kjaergaard-lab/fpga-servo/documentation/ClosedLoop.pdf

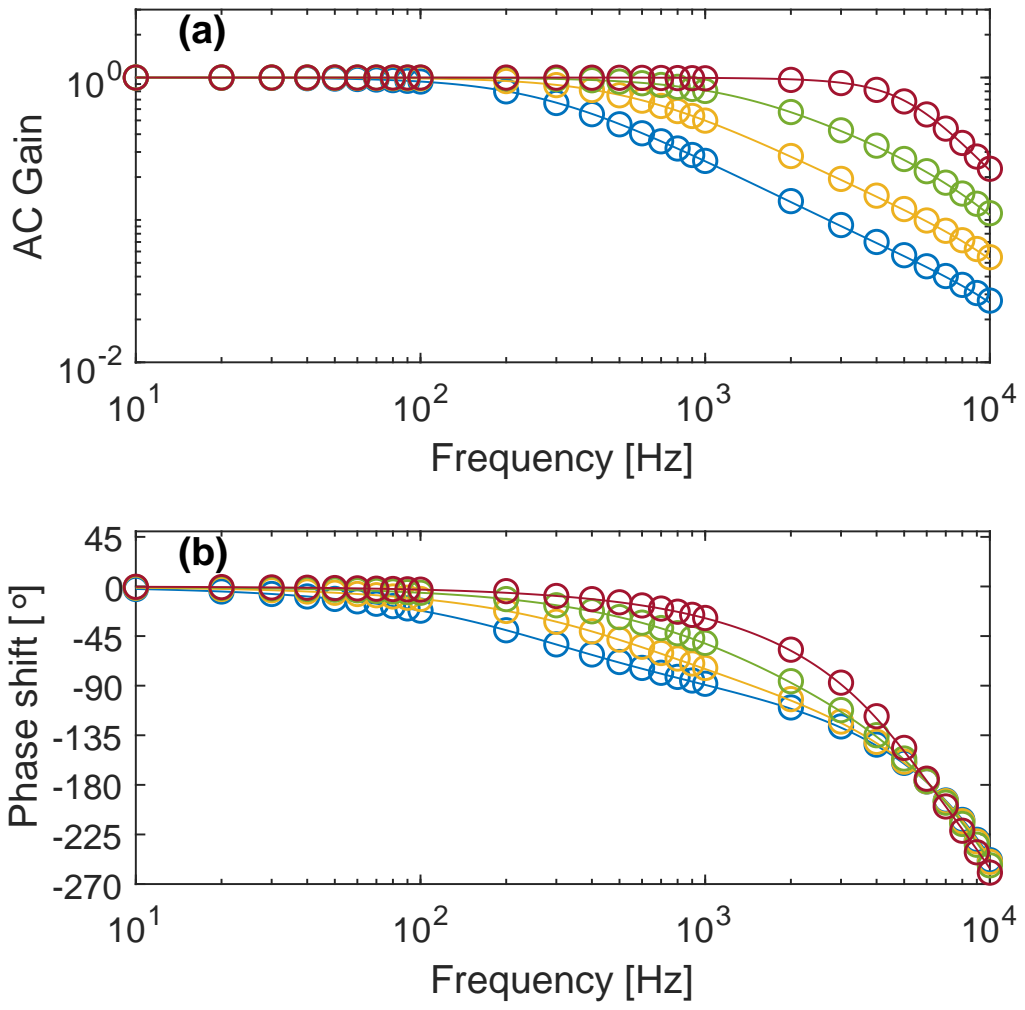
[picture p4: page 1]
Frequency [Hz]; AC Gain; Phase shift [°]
