kjaergaard-lab/fpga-servo/documentation/OpenLoop.pdf

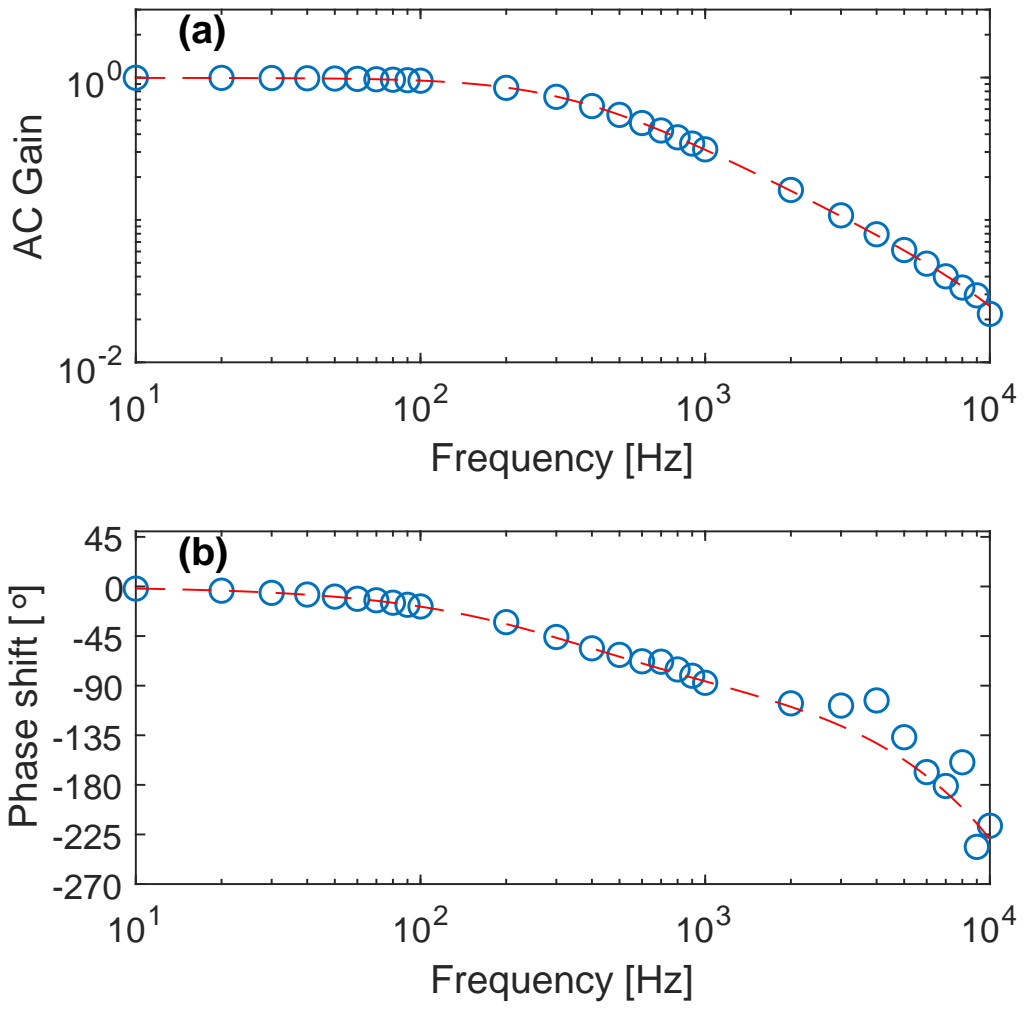
[picture p5: page 1]
Frequency [Hz]; AC Gain; Phase shift [°]
