kjaergaard-lab/fpga-servo/dual-servo/ipcore_dir/s6_lpddr_2channel/user_design/rtl/mcb_raw_wrapper.vhd

--*****************************************************************************
-- (c) Copyright 2009 Xilinx, Inc. All rights reserved.
--
-- This file contains confidential and proprietary information
-- of Xilinx, Inc. and is protected under U.S. and
-- international copyright and other intellectual property
-- laws.
--
-- DISCLAIMER
-- This disclaimer is not a license and does not grant any
-- rights to the materials distributed herewith. Except as
-- otherwise provided in a valid license issued to you by
-- Xilinx, and to the maximum extent permitted by applicable
-- law: (1) THESE MATERIALS ARE MADE AVAILABLE "AS IS" AND
-- WITH ALL FAULTS, AND XILINX HEREBY DISCLAIMS ALL WARRANTIES
-- AND CONDITIONS, EXPRESS, IMPLIED, OR STATUTORY, INCLUDING
-- BUT NOT LIMITED TO WARRANTIES OF MERCHANTABILITY, NON-
-- INFRINGEMENT, OR FITNESS FOR ANY PARTICULAR PURPOSE; and
-- (2) Xilinx shall not be liable (whether in contract or tort,
-- including negligence, or under any other theory of
-- liability) for any loss or damage of any kind or nature
-- related to, arising under or in connection with these
-- materials, including for any direct, or any indirect,
-- special, incidental, or consequential loss or damage
-- (including loss of data, profits, goodwill, or any type of
-- loss or damage suffered as a result of any action brought
-- by a third party) even if such damage or loss was
-- reasonably foreseeable or Xilinx had been advised of the
-- possibility of the same.
--
-- CRITICAL APPLICATIONS
-- Xilinx products are not designed or intended to be fail-
-- safe, or for use in any application requiring fail-safe
-- performance, such as life-support or safety devices or
-- systems, Class III medical devices, nuclear facilities,
-- applications related to the deployment of airbags, or any
-- other applications that could lead to death, personal
-- injury, or severe property or environmental damage
-- (individually and collectively, "Critical
-- Applications"). Customer assumes the sole risk and
-- liability of any use of Xilinx products in Critical
-- Applications, subject only to applicable laws and
-- regulations governing limitations on product liability.
--
-- THIS COPYRIGHT NOTICE AND DISCLAIMER MUST BE RETAINED AS
-- PART OF THIS FILE AT ALL TIMES.
--
--*****************************************************************************
--   ____  ____
--  /   /\/   /
-- /___/  \  /    Vendor: Xilinx
-- \   \   \/     Version: %version
--  \   \         Application: MIG
--  /   /         Filename: mcb_raw_wrapper.v
-- /___/   /\     Date Last Modified: $Date: 2011/06/02 07:17:04 $
-- \   \  /  \    Date Created: Thu June 24 2008
--  \___\/\___\
--
--Device: Spartan6
--Design Name: DDR/DDR2/DDR3/LPDDR 
--Purpose:
--Reference:
--   This module is the intialization control logic of the memory interface.
--   All commands are issued from here acoording to the burst, CAS Latency and
--   the user commands.
--   
-- Revised History:  
--    Rev 1.1 - added port_enable assignment for all configurations  and rearrange 
--              assignment siganls according to port number
--            - added timescale directive  -SN 7-28-08
--            - added C_ARB_NUM_TIME_SLOTS and removed the slot 12 through 
--              15 -SN 7-28-08
--            - changed C_MEM_DDR2_WRT_RECOVERY = (C_MEM_TWR /C_MEMCLK_PERIOD) -SN 7-28-08
--            - removed ghighb, gpwrdnb, gsr, gwe in port declaration. 
--              For now tb need to force the signals inside the MCB and Wrapper
--              until a glbl.v is ready.  Not sure how to do this in NCVerilog 
--              flow. -SN 7-28-08
--
--    Rev 1.2 -- removed p*_cmd_error signals -SN 8-05-08
--    Rev 1.3 -- Added gate logic for data port rd_en and wr_en in Config 3,4,5   - SN 8-8-08
--    Rev 1.4 -- update changes that required by MCB core.  - SN 9-11-09
--    Rev 1.5 -- update. CMD delays has been removed in Sept 26 database. -- SN 9-28-08
--               delay_cas_90,delay_ras_90,delay_cke_90,delay_odt_90,delay_rst_90 
--               delay_we_90 ,delay_address,delay_ba_90 =
--              --removed :assign #50 delay_dqnum = dqnum;
--              --removed :assign #50 delay_dqpum = dqpum;
--              --removed :assign #50 delay_dqnlm = dqnlm;
--              --removed :assign #50 delay_dqplm = dqplm;
--              --removed : delay_dqsIO_w_en_90_n
--              --removed : delay_dqsIO_w_en_90_p              
--              --removed : delay_dqsIO_w_en_0     
--              -- corrected spelling error: C_MEM_RTRAS
--    Rev 1.6 -- update IODRP2 and OSERDES connection and was updated by Chip.  1-12-09              
--                 -- rename the memc_wrapper.v to mcb_raw_wrapper.v
--    Rev 1.7  -- --  .READEN    is removed in IODRP2_MCB 1-28-09
--              -- connection has been updated                            
--    Rev 1.8   -- update memory parameter equations.    1-30_2009
--              -- added portion of Soft IP               
--              -- CAL_CLK_DIV is not used but MCB still has it
--    Rev  1.9  -- added Error checking for Invalid command to unidirectional port   
--    Rev  1.10 -- changed the backend connection so that Simulation will work while
--                 sw tools try to fix the model issues.                  2-3-2009      
--                 sysclk_2x_90 name is changed to sysclk_2x_180 . It created confusions.
--                 It is acutally 180 degree difference.
--    Rev  1.11 -- Added MCB_Soft_Calibration_top. 
--    Rev  1.12 -- fixed ui_clk connection to MCB when soft_calib_ip is on. 5-14-2009   
--    Rev  1.13 -- Added PULLUP/PULLDN for DQS/DQSN, UDQS/UDQSN lines.
--    Rev  1.14 -- Added minium condition for tRTP valud/                        
--    REv  1.15 -- Bring the SKIP_IN_TERM_CAL and SKIP_DYNAMIC_CAL from calib_ip to top.  6-16-2009
--    Rev  1.16 -- Fixed the WTR for DDR. 6-23-2009
--    Rev  1.17 -- Fixed width mismatch for px_cmd_ra,px_cmd_ca,px_cmd_ba 7-02-2009
--    Rev  1.18 -- Added lumpdelay parameters for 1.0 silicon support to bypass Calibration 7-10-2010
--    Rev  1.19 -- Added soft fix to support refresh command. 7-15-2009.
--    Rev  1.20 -- Turned on the CALIB_SOFT_IP and C_MC_CALIBRATION_MODE is used to enable/disable
--                 Dynamic DQS calibration in Soft Calibration module.
--    Rev  1.21 -- Added extra generate mcbx_dram_odt pin condition. It will not be generated if
--                 RTT value is set to "disabled"
--              -- Corrected the UIUDQSDEC connection between soft_calib and MCB.
--              -- PLL_LOCK pin to MCB tie high. Soft Calib module asserts MCB_RST when pll_lock is deasserted. 1-19-2010                
--    Rev  1.22 -- Added DDR2 Initialization fix to meet 400 ns wait as outlined in step d) of JEDEC DDR2 spec .
--    Rev  1.23 -- Fixed  CR 558661.  In Config "B64B64" mode, mig_p5_wr_data  <= p1_wr_data(63 downto 32).
--    Rev  1.24 -- Added DDR2 Initialization fix when C_CALIB_SOFT_IP set to "FALSE"
--    Rev  1.25 -- Fixed reset problem when MCB exits from SUSPEND SELFREFRESH mode. 10-20-2010	 
--    Rev  1.26 -- Synchronize sys_rst before connecting to mcb_soft_calibration module to fix
--                 CDC static timing issue.	 2-14-2011


--*************************************************************************************************************************
library ieee;
   use ieee.std_logic_1164.all;
   use ieee.std_logic_unsigned.all;
library unisim;
use unisim.vcomponents.all;

entity mcb_raw_wrapper is
generic(
      C_MEMCLK_PERIOD                  : integer := 2500;
      C_PORT_ENABLE                    : std_logic_vector(5 downto 0) := (others => '1');

      C_MEM_ADDR_ORDER                 : string := "BANK_ROW_COLUMN";
      
      C_ARB_NUM_TIME_SLOTS             : integer := 12;
      C_ARB_TIME_SLOT_0                : bit_vector(17 downto 0):= "000" & "001" & "010" & "011" & "100" & "101";
      C_ARB_TIME_SLOT_1                : bit_vector(17 downto 0):= "001" & "010" & "011" & "100" & "101" & "000";
      C_ARB_TIME_SLOT_2                : bit_vector(17 downto 0):= "010" & "011" & "100" & "101" & "000" & "011"; 
      C_ARB_TIME_SLOT_3                : bit_vector(17 downto 0):= "011" & "100" & "101" & "000" & "001" & "010";
      C_ARB_TIME_SLOT_4                : bit_vector(17 downto 0):= "100" & "101" & "000" & "001" & "010" & "011";
      C_ARB_TIME_SLOT_5                : bit_vector(17 downto 0):= "101" & "000" & "001" & "010" & "011" & "100";
      C_ARB_TIME_SLOT_6                : bit_vector(17 downto 0):= "000" & "001" & "010" & "011" & "100" & "101";
      C_ARB_TIME_SLOT_7                : bit_vector(17 downto 0):= "001" & "010" & "011" & "100" & "101" & "000";
      C_ARB_TIME_SLOT_8                : bit_vector(17 downto 0):= "010" & "011" & "100" & "101" & "000" & "011"; 
      C_ARB_TIME_SLOT_9                : bit_vector(17 downto 0):= "011" & "100" & "101" & "000" & "001" & "010";
      C_ARB_TIME_SLOT_10               : bit_vector(17 downto 0):= "100" & "101" & "000" & "001" & "010" & "011";
      C_ARB_TIME_SLOT_11               : bit_vector(17 downto 0):= "101" & "000" & "001" & "010" & "011" & "100";
      C_PORT_CONFIG                    : string :=  "B32_B32_W32_W32_W32_W32";  

      
      C_MEM_TRAS                       : integer := 45000;
      C_MEM_TRCD                       : integer := 12500;
      C_MEM_TREFI                      : integer := 7800;
      C_MEM_TRFC                       : integer := 127500;
      C_MEM_TRP                        : integer := 12500;
      C_MEM_TWR                        : integer := 15000;
      C_MEM_TRTP                       : integer := 7500;
      C_MEM_TWTR                       : integer := 7500;
      
      C_NUM_DQ_PINS                    : integer := 8;
      C_MEM_TYPE                       : string := "DDR3";
      C_MEM_DENSITY                    : string := "512M";
      C_MEM_BURST_LEN                  : integer := 8;
      
      C_MEM_CAS_LATENCY                : integer := 4;
      C_MEM_ADDR_WIDTH                 : integer := 13;
      C_MEM_BANKADDR_WIDTH             : integer := 3;
      C_MEM_NUM_COL_BITS               : integer := 11;
      
      C_MEM_DDR3_CAS_LATENCY           : integer := 7;
      C_MEM_MOBILE_PA_SR               : string := "FULL";
      C_MEM_DDR1_2_ODS                 : string := "FULL";
      C_MEM_DDR3_ODS                   : string := "DIV6";
      C_MEM_DDR2_RTT                   : string := "50OHMS";
      C_MEM_DDR3_RTT                   : string := "DIV2";
      C_MEM_MDDR_ODS                   : string := "FULL";
      
      C_MEM_DDR2_DIFF_DQS_EN           : string := "YES";
      C_MEM_DDR2_3_PA_SR               : string := "OFF";
      C_MEM_DDR3_CAS_WR_LATENCY        : integer := 5;
      
      C_MEM_DDR3_AUTO_SR               : string := "ENABLED";
      C_MEM_DDR2_3_HIGH_TEMP_SR        : string := "NORMAL";
      C_MEM_DDR3_DYN_WRT_ODT           : string := "OFF";
      C_MEM_TZQINIT_MAXCNT             : std_logic_vector(9 downto 0) := "1000000000"; -- DDR3 Minimum delay between resets 
      
      C_MC_CALIB_BYPASS                : string := "NO";
      C_MC_CALIBRATION_RA              : bit_vector(15 downto 0) := X"0000";
      C_MC_CALIBRATION_BA              : bit_vector(2 downto 0) := "000";

      C_CALIB_SOFT_IP                  : string := "TRUE";
      C_SKIP_IN_TERM_CAL               : integer := 0;        --provides option to skip the input termination calibration
      C_SKIP_DYNAMIC_CAL               : integer := 0;        --provides option to skip the dynamic delay calibration
      C_SKIP_DYN_IN_TERM               : integer := 1;        -- provides option to skip the input termination calibration
      C_SIMULATION                     : string  := "FALSE";  -- Tells us whether the design is being simulated or implemented


--- ADDED for 1.0 silicon support to bypass Calibration //////
-- 07-10-09 chipl
--////////////////////////////////////////////////////////////
     LDQSP_TAP_DELAY_VAL                : integer := 0;
     UDQSP_TAP_DELAY_VAL                : integer := 0;
     LDQSN_TAP_DELAY_VAL                : integer := 0;
     UDQSN_TAP_DELAY_VAL                : integer := 0;
     DQ0_TAP_DELAY_VAL                  : integer := 0;  
     DQ1_TAP_DELAY_VAL                  : integer := 0;  
     DQ2_TAP_DELAY_VAL                  : integer := 0;  
     DQ3_TAP_DELAY_VAL                  : integer := 0;  
     DQ4_TAP_DELAY_VAL                  : integer := 0;  
     DQ5_TAP_DELAY_VAL                  : integer := 0;  
     DQ6_TAP_DELAY_VAL                  : integer := 0;  
     DQ7_TAP_DELAY_VAL                  : integer := 0;  
     DQ8_TAP_DELAY_VAL                  : integer := 0;  
     DQ9_TAP_DELAY_VAL                  : integer := 0;  
     DQ10_TAP_DELAY_VAL                  : integer := 0;  
     DQ11_TAP_DELAY_VAL                  : integer := 0;  
     DQ12_TAP_DELAY_VAL                  : integer := 0;  
     DQ13_TAP_DELAY_VAL                  : integer := 0;  
     DQ14_TAP_DELAY_VAL                  : integer := 0;  
     DQ15_TAP_DELAY_VAL                  : integer := 0;  

      C_MC_CALIBRATION_CA              : bit_vector(11 downto 0) := X"000";
      C_MC_CALIBRATION_CLK_DIV         : integer := 1;
      C_MC_CALIBRATION_MODE            : string := "CALIBRATION";
      C_MC_CALIBRATION_DELAY           : string := "HALF";
      
      C_P0_MASK_SIZE                   : integer := 4;
      C_P0_DATA_PORT_SIZE              : integer := 32;
      C_P1_MASK_SIZE                   : integer := 4;
      C_P1_DATA_PORT_SIZE              : integer := 32
      );
   PORT (

      sysclk_2x                        : in std_logic;
      sysclk_2x_180                    : in std_logic;
      pll_ce_0                         : in std_logic;
      pll_ce_90                        : in std_logic;
      pll_lock                         : in std_logic;
      sys_rst                          : in std_logic;
      
      p0_arb_en                        : in std_logic;
      p0_cmd_clk                       : in std_logic;
      p0_cmd_en                        : in std_logic;
      p0_cmd_instr                     : in std_logic_vector(2 downto 0);
      p0_cmd_bl                        : in std_logic_vector(5 downto 0);
      p0_cmd_byte_addr                 : in std_logic_vector(29 downto 0);
      p0_cmd_empty                     : out std_logic;
      p0_cmd_full                      : out std_logic;

      p0_wr_clk                        : in std_logic;
      p0_wr_en                         : in std_logic;
      p0_wr_mask                       : in std_logic_vector(C_P0_MASK_SIZE - 1 downto 0);
      p0_wr_data                       : in std_logic_vector(C_P0_DATA_PORT_SIZE - 1 downto 0);
      p0_wr_full                       : out std_logic;
      p0_wr_empty                      : out std_logic;
      p0_wr_count                      : out std_logic_vector(6 downto 0);
      p0_wr_underrun                   : out std_logic;
      p0_wr_error                      : out std_logic;

      p0_rd_clk                        : in std_logic;
      p0_rd_en                         : in std_logic;
      p0_rd_data                       : out std_logic_vector(C_P0_DATA_PORT_SIZE - 1 downto 0);
      p0_rd_full                       : out std_logic;
      p0_rd_empty                      : out std_logic;
      p0_rd_count                      : out std_logic_vector(6 downto 0);
      p0_rd_overflow                   : out std_logic;
      p0_rd_error                      : out std_logic;

      p1_arb_en                        : in std_logic;
      p1_cmd_clk                       : in std_logic;
      p1_cmd_en                        : in std_logic;
      p1_cmd_instr                     : in std_logic_vector(2 downto 0);
      p1_cmd_bl                        : in std_logic_vector(5 downto 0);
      p1_cmd_byte_addr                 : in std_logic_vector(29 downto 0);
      p1_cmd_empty                     : out std_logic;
      p1_cmd_full                      : out std_logic;
      p1_wr_clk                        : in std_logic;
      p1_wr_en                         : in std_logic;
      p1_wr_mask                       : in std_logic_vector(C_P1_MASK_SIZE - 1 downto 0);
      p1_wr_data                       : in std_logic_vector(C_P1_DATA_PORT_SIZE - 1 downto 0);
      p1_wr_full                       : out std_logic;
      p1_wr_empty                      : out std_logic;
      p1_wr_count                      : out std_logic_vector(6 downto 0);
      p1_wr_underrun                   : out std_logic;
      p1_wr_error                      : out std_logic;
      p1_rd_clk                        : in std_logic;
      p1_rd_en                         : in std_logic;
      p1_rd_data                       : out std_logic_vector(C_P1_DATA_PORT_SIZE - 1 downto 0);
      p1_rd_full                       : out std_logic;
      p1_rd_empty                      : out std_logic;
      p1_rd_count                      : out std_logic_vector(6 downto 0);
      p1_rd_overflow                   : out std_logic;
      p1_rd_error                      : out std_logic;

      p2_arb_en                        : in std_logic;
      p2_cmd_clk                       : in std_logic;
      p2_cmd_en                        : in std_logic;
      p2_cmd_instr                     : in std_logic_vector(2 downto 0);
      p2_cmd_bl                        : in std_logic_vector(5 downto 0);
      p2_cmd_byte_addr                 : in std_logic_vector(29 downto 0);
      p2_cmd_empty                     : out std_logic;
      p2_cmd_full                      : out std_logic;
      p2_wr_clk                        : in std_logic;
      p2_wr_en                         : in std_logic;
      p2_wr_mask                       : in std_logic_vector(3 downto 0);
      p2_wr_data                       : in std_logic_vector(31 downto 0);
      p2_wr_full                       : out std_logic;
      p2_wr_empty                      : out std_logic;
      p2_wr_count                      : out std_logic_vector(6 downto 0);
      p2_wr_underrun                   : out std_logic;
      p2_wr_error                      : out std_logic;
      p2_rd_clk                        : in std_logic;
      p2_rd_en                         : in std_logic;
      p2_rd_data                       : out std_logic_vector(31 downto 0);
      p2_rd_full                       : out std_logic;
      p2_rd_empty                      : out std_logic;
      p2_rd_count                      : out std_logic_vector(6 downto 0);
      p2_rd_overflow                   : out std_logic;
      p2_rd_error                      : out std_logic;

      p3_arb_en                        : in std_logic;
      p3_cmd_clk                       : in std_logic;
      p3_cmd_en                        : in std_logic;
      p3_cmd_instr                     : in std_logic_vector(2 downto 0);
      p3_cmd_bl                        : in std_logic_vector(5 downto 0);
      p3_cmd_byte_addr                 : in std_logic_vector(29 downto 0);
      p3_cmd_empty                     : out std_logic;
      p3_cmd_full                      : out std_logic;
      p3_wr_clk                        : in std_logic;
      p3_wr_en                         : in std_logic;
      p3_wr_mask                       : in std_logic_vector(3 downto 0);
      p3_wr_data                       : in std_logic_vector(31 downto 0);
      p3_wr_full                       : out std_logic;
      p3_wr_empty                      : out std_logic;
      p3_wr_count                      : out std_logic_vector(6 downto 0);
      p3_wr_underrun                   : out std_logic;
      p3_wr_error                      : out std_logic;
      p3_rd_clk                        : in std_logic;
      p3_rd_en                         : in std_logic;
      p3_rd_data                       : out std_logic_vector(31 downto 0);
      p3_rd_full                       : out std_logic;
      p3_rd_empty                      : out std_logic;
      p3_rd_count                      : out std_logic_vector(6 downto 0);
      p3_rd_overflow                   : out std_logic;
      p3_rd_error                      : out std_logic;

      p4_arb_en                        : in std_logic;
      p4_cmd_clk                       : in std_logic;
      p4_cmd_en                        : in std_logic;
      p4_cmd_instr                     : in std_logic_vector(2 downto 0);
      p4_cmd_bl                        : in std_logic_vector(5 downto 0);
      p4_cmd_byte_addr                 : in std_logic_vector(29 downto 0);
      p4_cmd_empty                     : out std_logic;
      p4_cmd_full                      : out std_logic;
      p4_wr_clk                        : in std_logic;
      p4_wr_en                         : in std_logic;
      p4_wr_mask                       : in std_logic_vector(3 downto 0);
      p4_wr_data                       : in std_logic_vector(31 downto 0);
      p4_wr_full                       : out std_logic;
      p4_wr_empty                      : out std_logic;
      p4_wr_count                      : out std_logic_vector(6 downto 0);
      p4_wr_underrun                   : out std_logic;
      p4_wr_error                      : out std_logic;
      p4_rd_clk                        : in std_logic;
      p4_rd_en                         : in std_logic;
      p4_rd_data                       : out std_logic_vector(31 downto 0);
      p4_rd_full                       : out std_logic;
      p4_rd_empty                      : out std_logic;
      p4_rd_count                      : out std_logic_vector(6 downto 0);
      p4_rd_overflow                   : out std_logic;
      p4_rd_error                      : out std_logic;

      p5_arb_en                        : in std_logic;
      p5_cmd_clk                       : in std_logic;
      p5_cmd_en                        : in std_logic;
      p5_cmd_instr                     : in std_logic_vector(2 downto 0);
      p5_cmd_bl                        : in std_logic_vector(5 downto 0);
      p5_cmd_byte_addr                 : in std_logic_vector(29 downto 0);
      p5_cmd_empty                     : out std_logic;
      p5_cmd_full                      : out std_logic;
      p5_wr_clk                        : in std_logic;
      p5_wr_en                         : in std_logic;
      p5_wr_mask                       : in std_logic_vector(3 downto 0);
      p5_wr_data                       : in std_logic_vector(31 downto 0);
      p5_wr_full                       : out std_logic;
      p5_wr_empty                      : out std_logic;
      p5_wr_count                      : out std_logic_vector(6 downto 0);
      p5_wr_underrun                   : out std_logic;
      p5_wr_error                      : out std_logic;
      p5_rd_clk                        : in std_logic;
      p5_rd_en                         : in std_logic;
      p5_rd_data                       : out std_logic_vector(31 downto 0);
      p5_rd_full                       : out std_logic;
      p5_rd_empty                      : out std_logic;
      p5_rd_count                      : out std_logic_vector(6 downto 0);
      p5_rd_overflow                   : out std_logic;
      p5_rd_error                      : out std_logic;

      mcbx_dram_addr                   : out std_logic_vector(C_MEM_ADDR_WIDTH - 1 downto 0);
      mcbx_dram_ba                     : out std_logic_vector(C_MEM_BANKADDR_WIDTH - 1 downto 0);
      mcbx_dram_ras_n                  : out std_logic;
      mcbx_dram_cas_n                  : out std_logic;
      mcbx_dram_we_n                   : out std_logic;
      mcbx_dram_cke                    : out std_logic;
      mcbx_dram_clk                    : out std_logic;
      mcbx_dram_clk_n                  : out std_logic;
      mcbx_dram_dq                     : INOUT std_logic_vector(C_NUM_DQ_PINS-1 downto 0);
      mcbx_dram_dqs                    : INOUT std_logic;
      mcbx_dram_dqs_n                  : INOUT std_logic;
      mcbx_dram_udqs                   : INOUT std_logic;
      mcbx_dram_udqs_n                 : INOUT std_logic;
      mcbx_dram_udm                    : out std_logic;
      mcbx_dram_ldm                    : out std_logic;
      mcbx_dram_odt                    : out std_logic;
      mcbx_dram_ddr3_rst               : out std_logic;

      calib_recal                      : in std_logic;
      rzq                              : INOUT std_logic;
      zio                              : INOUT std_logic;
      ui_read                          : in std_logic;
      ui_add                           : in std_logic;
      ui_cs                            : in std_logic;
      ui_clk                           : in std_logic;
      ui_sdi                           : in std_logic;
      ui_addr                          : in std_logic_vector(4 downto 0);
      ui_broadcast                     : in std_logic;
      ui_drp_update                    : in std_logic;
      ui_done_cal                      : in std_logic;
      ui_cmd                           : in std_logic;
      ui_cmd_in                        : in std_logic;
      ui_cmd_en                        : in std_logic;
      ui_dqcount                       : in std_logic_vector(3 downto 0);
      ui_dq_lower_dec                  : in std_logic;
      ui_dq_lower_inc                  : in std_logic;
      ui_dq_upper_dec                  : in std_logic;
      ui_dq_upper_inc                  : in std_logic;
      ui_udqs_inc                      : in std_logic;
      ui_udqs_dec                      : in std_logic;
      ui_ldqs_inc                      : in std_logic;
      ui_ldqs_dec                      : in std_logic;
      uo_data                          : out std_logic_vector(7 downto 0);
      uo_data_valid                    : out std_logic;
      uo_done_cal                      : out std_logic;
      uo_cmd_ready_in                  : out std_logic;
      uo_refrsh_flag                   : out std_logic;
      uo_cal_start                     : out std_logic;
      uo_sdo                           : out std_logic;
      status                           : out std_logic_vector(31 downto 0);
      selfrefresh_enter                : in std_logic;
      selfrefresh_mode                 : out std_logic
   );
end mcb_raw_wrapper;

 architecture aarch of mcb_raw_wrapper is
   
component mcb_soft_calibration_top is
   generic (
      C_MEM_TZQINIT_MAXCNT  : std_logic_vector(9 downto 0) := "1000000000"; -- DDR3 Minimum delay between resets 
      C_MC_CALIBRATION_MODE : string :=  "CALIBRATION";  -- if set to CALIBRATION will reset DQS IDELAY to DQS_NUMERATOR/DQS_DENOMINATOR local_param values,
                                                         --  and does dynamic recal,
                                                         -- if set to NOCALIBRATION then defaults to hard cal blocks setting of C_MC_CALBRATION_DELAY *and* 
                                                         --  no dynamic recal will be done 
      SKIP_IN_TERM_CAL      : integer := 0;             -- provides option to skip the input termination calibration
      SKIP_DYNAMIC_CAL      : integer := 0;             -- provides option to skip the dynamic delay calibration
      SKIP_DYN_IN_TERM      : integer := 0;             -- provides option to skip the dynamic delay calibration
      C_SIMULATION          : string  := "FALSE";       -- Tells us whether the design is being simulated or implemented
      C_MEM_TYPE            : string  := "DDR3"         -- provides the memory device used for the design

   );
   port (
      UI_CLK                : in std_logic;             -- Input - global clock to be used for input_term_tuner and IODRP clock
      RST                   : in std_logic;             -- Input - reset for input_term_tuner - synchronous for input_term_tuner state machine, asynch for 
                                                        --  IODRP (sub)controller
      IOCLK                 : in std_logic;             -- Input - IOCLK input to the IODRP's
      DONE_SOFTANDHARD_CAL  : out std_logic;            -- active high flag signals soft calibration of input delays is complete and MCB_UODONECAL is high
                                                        --  (MCB hard calib complete)
      PLL_LOCK              : in std_logic;             -- Lock signal from PLL
      SELFREFRESH_REQ       : in std_logic;             
      SELFREFRESH_MCB_MODE  : in std_logic;             
      SELFREFRESH_MCB_REQ   : out std_logic;            
      SELFREFRESH_MODE      : out std_logic;            
      MCB_UIADD             : out std_logic;            -- to MCB's UIADD port
      MCB_UISDI             : out std_logic;            -- to MCB's UISDI port
      MCB_UOSDO             : in std_logic;
      MCB_UODONECAL         : in std_logic;
      MCB_UOREFRSHFLAG      : in std_logic;
      MCB_UICS              : out std_logic;
      MCB_UIDRPUPDATE       : out std_logic;
      MCB_UIBROADCAST       : out std_logic;
      MCB_UIADDR            : out std_logic_vector(4 downto 0);
      MCB_UICMDEN           : out std_logic;
      MCB_UIDONECAL         : out std_logic;
      MCB_UIDQLOWERDEC      : out std_logic;
      MCB_UIDQLOWERINC      : out std_logic;
      MCB_UIDQUPPERDEC      : out std_logic;
      MCB_UIDQUPPERINC      : out std_logic;
      MCB_UILDQSDEC         : out std_logic;
      MCB_UILDQSINC         : out std_logic;
      MCB_UIREAD            : out std_logic;
      MCB_UIUDQSDEC         : out std_logic;
      MCB_UIUDQSINC         : out std_logic;
      MCB_RECAL             : out std_logic;
      MCB_SYSRST            : out std_logic;
      MCB_UICMD             : out std_logic;
      MCB_UICMDIN           : out std_logic;
      MCB_UIDQCOUNT         : out std_logic_vector(3 downto 0);
      MCB_UODATA            : in std_logic_vector(7 downto 0);
      MCB_UODATAVALID       : in std_logic;
      MCB_UOCMDREADY        : in std_logic;
      MCB_UO_CAL_START      : in std_logic;
      RZQ_PIN               : inout std_logic;
      ZIO_PIN               : inout std_logic;
      CKE_Train             : out std_logic
   );   
end component;

constant      C_OSERDES2_DATA_RATE_OQ          : STRING := "SDR";
constant      C_OSERDES2_DATA_RATE_OT          : STRING := "SDR";
constant      C_OSERDES2_SERDES_MODE_MASTER    : STRING := "MASTER";
constant      C_OSERDES2_SERDES_MODE_SLAVE     : STRING := "SLAVE";
constant      C_OSERDES2_OUTPUT_MODE_SE        : STRING := "SINGLE_ENDED";
constant      C_OSERDES2_OUTPUT_MODE_DIFF      : STRING := "DIFFERENTIAL";
      
constant      C_BUFPLL_0_LOCK_SRC              : STRING := "LOCK_TO_0";
      
constant      C_DQ_IODRP2_DATA_RATE            : STRING := "SDR";
constant      C_DQ_IODRP2_SERDES_MODE_MASTER   : STRING := "MASTER";
constant      C_DQ_IODRP2_SERDES_MODE_SLAVE    : STRING := "SLAVE";
      
constant      C_DQS_IODRP2_DATA_RATE           : STRING := "SDR";
constant      C_DQS_IODRP2_SERDES_MODE_MASTER  : STRING := "MASTER";
constant      C_DQS_IODRP2_SERDES_MODE_SLAVE   : STRING := "SLAVE";

-- MIG always set the below ADD_LATENCY to zero
constant      C_MEM_DDR3_ADD_LATENCY           : STRING := "OFF";
constant      C_MEM_DDR2_ADD_LATENCY           : INTEGER := 0;
constant      C_MEM_MOBILE_TC_SR               : INTEGER := 0;

-- convert the memory timing to memory clock units. I
constant      MEM_RAS_VAL   : INTEGER := ((C_MEM_TRAS + C_MEMCLK_PERIOD - 1) / C_MEMCLK_PERIOD);
constant      MEM_RCD_VAL   : INTEGER := ((C_MEM_TRCD + C_MEMCLK_PERIOD - 1) / C_MEMCLK_PERIOD);
constant      MEM_REFI_VAL  : INTEGER := ((C_MEM_TREFI + C_MEMCLK_PERIOD - 1) / C_MEMCLK_PERIOD) - 25;
constant      MEM_RFC_VAL   : INTEGER := ((C_MEM_TRFC + C_MEMCLK_PERIOD - 1) / C_MEMCLK_PERIOD);
constant      MEM_RP_VAL    : INTEGER := ((C_MEM_TRP + C_MEMCLK_PERIOD - 1) / C_MEMCLK_PERIOD);
constant      MEM_WR_VAL    : INTEGER := ((C_MEM_TWR + C_MEMCLK_PERIOD - 1) / C_MEMCLK_PERIOD);

 function cdiv return integer is
  begin
    if ( (C_MEM_TRTP mod C_MEMCLK_PERIOD)>0) then
      return (C_MEM_TRTP/C_MEMCLK_PERIOD)+1;
    else      
    return (C_MEM_TRTP/C_MEMCLK_PERIOD);
    end if;
  end function cdiv;

constant      MEM_RTP_VAL1                      : INTEGER := cdiv;


function MEM_RTP_CYC1 return integer is
  begin
    if (MEM_RTP_VAL1 < 4 and C_MEM_TYPE = "DDR3") then
      return 4;
    else if(MEM_RTP_VAL1 < 2) then
      return 2;
    else
      return MEM_RTP_VAL1;
    end if;
    end if;
  end function MEM_RTP_CYC1;

constant      MEM_RTP_VAL                      : INTEGER := MEM_RTP_CYC1;

function MEM_WTR_CYC return integer is
  begin
    if (C_MEM_TYPE = "DDR") then
      return 2;
    elsif (C_MEM_TYPE = "DDR3") then
      return 4;
    elsif (C_MEM_TYPE = "MDDR" OR C_MEM_TYPE = "LPDDR") then
      return C_MEM_TWTR;
    elsif (C_MEM_TYPE = "DDR2"  AND (((C_MEM_TWTR  + C_MEMCLK_PERIOD -1) /C_MEMCLK_PERIOD) > 2)) then
      return ((C_MEM_TWTR  + C_MEMCLK_PERIOD -1) /C_MEMCLK_PERIOD);
    elsif (C_MEM_TYPE = "DDR2")then
      return 2;
    else
      return 3;
    end if;
  end function MEM_WTR_CYC;

constant      MEM_WTR_VAL                      : INTEGER := MEM_WTR_CYC;

function DDR2_WRT_RECOVERY_CYC return integer is
  begin
    if (not(C_MEM_TYPE = "DDR2")) then
      return 5;
    else
      return ((C_MEM_TWR + C_MEMCLK_PERIOD - 1) / C_MEMCLK_PERIOD);
    end if;
  end function DDR2_WRT_RECOVERY_CYC;


constant        C_MEM_DDR2_WRT_RECOVERY          : INTEGER := DDR2_WRT_RECOVERY_CYC;

function DDR3_WRT_RECOVERY_CYC return integer is
  begin
    if (not(C_MEM_TYPE = "DDR3")) then
      return 5;
    else
      return ((C_MEM_TWR + C_MEMCLK_PERIOD - 1) / C_MEMCLK_PERIOD);
    end if;
  end function DDR3_WRT_RECOVERY_CYC;

constant      C_MEM_DDR3_WRT_RECOVERY          : INTEGER := DDR3_WRT_RECOVERY_CYC;

--CR 596422
constant allzero : std_logic_vector(127 downto 0) := (others => '0');
--signal allzero : std_logic_vector(127 downto 0) := (others => '0');

----------------------------------------------------------------------------
-- signal Declarations
----------------------------------------------------------------------------
signal addr_in0 : std_logic_vector(31 downto 0);
signal dqs_out_p : std_logic;              
signal dqs_out_n : std_logic;              
signal dqs_sys_p : std_logic;             --from dqs_gen to IOclk network
signal dqs_sys_n : std_logic;             --from dqs_gen to IOclk network
signal udqs_sys_p: std_logic;
signal udqs_sys_n: std_logic;
signal dqs_p : std_logic;                  -- open net now ?
signal dqs_n : std_logic;                  -- open net now ?

-- IOI and IOB enable/tristate interface
signal dqIO_w_en_0      : std_logic;          --enable DQ pads
signal dqsIO_w_en_90_p  : std_logic;          --enable p side of DQS
signal dqsIO_w_en_90_n  : std_logic;          --enable n side of DQS

--memory chip control interface
signal address_90 : std_logic_vector(14 downto 0);
signal ba_90  : std_logic_vector(2 downto 0);   
signal ras_90 : std_logic;
signal cas_90 : std_logic;
signal we_90  : std_logic;
signal cke_90 : std_logic;
signal odt_90 : std_logic;
signal rst_90 : std_logic;

-- calibration IDELAY control  signals
signal ioi_drp_clk       : std_logic;   --DRP interface - synchronous clock output
signal ioi_drp_addr      : std_logic_vector(4 downto 0);   --DRP interface - IOI selection
signal ioi_drp_sdo       : std_logic;   --DRP interface - serial output for commmands
signal ioi_drp_sdi       : std_logic;   --DRP interface - serial input for commands
signal ioi_drp_cs        : std_logic;   --DRP interface - chip select doubles as DONE signal
signal ioi_drp_add       : std_logic;   --DRP interface - serial address signal
signal ioi_drp_broadcast : std_logic; 
signal ioi_drp_train     : std_logic;

-- Calibration datacapture siganls
signal dqdonecount : std_logic_vector(3 downto 0); --select signal for the datacapture 16 to 1 mux
signal dq_in_p : std_logic;         --positive signal sent to calibration logic
signal dq_in_n : std_logic;         --negative signal sent to calibration logic
signal cal_done: std_logic;   

--DQS calibration interface
signal udqs_n : std_logic;
signal udqs_p : std_logic;
signal udqs_dqocal_p : std_logic;
signal udqs_dqocal_n : std_logic;

-- MUI enable interface
signal df_en_n90 : std_logic;

--INTERNAL signal FOR DRP chain
-- IOI <-> MUI
signal ioi_int_tmp : std_logic;

signal dqo_n : std_logic_vector(15 downto 0);  
signal dqo_p : std_logic_vector(15 downto 0);  
signal dqnlm : std_logic;      
signal dqplm : std_logic;      
signal dqnum : std_logic;      
signal dqpum : std_logic;      

-- IOI <-> IOB   routes
signal  ioi_addr  : std_logic_vector(C_MEM_ADDR_WIDTH-1 downto 0);
signal  ioi_ba : std_logic_vector(C_MEM_BANKADDR_WIDTH-1 downto 0);    
signal  ioi_cas : std_logic;  
signal  ioi_ck  : std_logic;  
signal  ioi_ckn : std_logic;   
signal  ioi_cke : std_logic;  
signal  ioi_dq : std_logic_vector(C_NUM_DQ_PINS-1 downto 0); 
signal  ioi_dqs  : std_logic; 
signal  ioi_dqsn : std_logic;
signal  ioi_udqs : std_logic;
signal  ioi_udqsn : std_logic;   
signal  ioi_odt  : std_logic; 
signal  ioi_ras  : std_logic; 
signal  ioi_rst  : std_logic; 
signal  ioi_we   : std_logic;
signal  ioi_udm  : std_logic;
signal  ioi_ldm  : std_logic;

signal  in_dq     : std_logic_vector(15 downto 0);
signal  in_pre_dq : std_logic_vector(C_NUM_DQ_PINS-1 downto 0);
signal  in_dqs       : std_logic;
signal  in_pre_dqsp  : std_logic;
signal  in_pre_dqsn  : std_logic;
signal  in_pre_udqsp : std_logic;
signal  in_pre_udqsn : std_logic;
signal  in_udqs      : std_logic;

-- Memory tri-state control signals
signal  t_addr  : std_logic_vector(C_MEM_ADDR_WIDTH-1 downto 0);
signal  t_ba    : std_logic_vector(C_MEM_BANKADDR_WIDTH-1 downto 0);    
signal  t_cas   : std_logic;
signal  t_ck    : std_logic;
signal  t_ckn   : std_logic;
signal  t_cke   : std_logic;
signal  t_dq    : std_logic_vector(C_NUM_DQ_PINS-1 downto 0);
signal  t_dqs   : std_logic;   
signal  t_dqsn  : std_logic;
signal  t_udqs  : std_logic;
signal  t_udqsn : std_logic;
signal  t_odt   : std_logic;   
signal  t_ras   : std_logic;   
signal  t_rst   : std_logic;   
signal  t_we    : std_logic;   

signal t_udm             : std_logic;
signal t_ldm             : std_logic;

signal idelay_dqs_ioi_s  : std_logic;
signal idelay_dqs_ioi_m  : std_logic;
signal idelay_udqs_ioi_s : std_logic;
signal idelay_udqs_ioi_m : std_logic;

signal dqs_pin           : std_logic;
signal udqs_pin          : std_logic;

-- USER Interface signals
-- translated memory addresses
signal p0_cmd_ra : std_logic_vector(14 downto 0);
signal p0_cmd_ba : std_logic_vector(2 downto 0);
signal p0_cmd_ca : std_logic_vector(11 downto 0);
signal p1_cmd_ra : std_logic_vector(14 downto 0);
signal p1_cmd_ba : std_logic_vector(2 downto 0);
signal p1_cmd_ca : std_logic_vector(11 downto 0);
signal p2_cmd_ra : std_logic_vector(14 downto 0);
signal p2_cmd_ba : std_logic_vector(2 downto 0);
signal p2_cmd_ca : std_logic_vector(11 downto 0);
signal p3_cmd_ra : std_logic_vector(14 downto 0);
signal p3_cmd_ba : std_logic_vector(2 downto 0);
signal p3_cmd_ca : std_logic_vector(11 downto 0);
signal p4_cmd_ra : std_logic_vector(14 downto 0);
signal p4_cmd_ba : std_logic_vector(2 downto 0);
signal p4_cmd_ca : std_logic_vector(11 downto 0);
signal p5_cmd_ra : std_logic_vector(14 downto 0);
signal p5_cmd_ba : std_logic_vector(2 downto 0);
signal p5_cmd_ca : std_logic_vector(11 downto 0);

   -- user command wires mapped from logical ports to physical ports
signal mig_p0_arb_en            : std_logic;
signal mig_p0_cmd_clk           : std_logic;
signal mig_p0_cmd_en            : std_logic;
signal mig_p0_cmd_ra            : std_logic_vector(14 downto 0);
signal mig_p0_cmd_ba            : std_logic_vector(2 downto 0);
signal mig_p0_cmd_ca            : std_logic_vector(11 downto 0);

signal mig_p0_cmd_instr         : std_logic_vector(2 downto 0);
signal mig_p0_cmd_bl            : std_logic_vector(5 downto 0);
signal mig_p0_cmd_empty         : std_logic;
signal mig_p0_cmd_full          : std_logic;

signal mig_p1_arb_en            : std_logic;
signal mig_p1_cmd_clk           : std_logic;
signal mig_p1_cmd_en            : std_logic;
signal mig_p1_cmd_ra            : std_logic_vector(14 downto 0);
signal mig_p1_cmd_ba            : std_logic_vector(2 downto 0);
signal mig_p1_cmd_ca            : std_logic_vector(11 downto 0);

signal mig_p1_cmd_instr         : std_logic_vector(2 downto 0);
signal mig_p1_cmd_bl            : std_logic_vector(5 downto 0);
signal mig_p1_cmd_empty         : std_logic;
signal mig_p1_cmd_full          : std_logic;

signal mig_p2_arb_en            : std_logic;
signal mig_p2_cmd_clk           : std_logic;
signal mig_p2_cmd_en            : std_logic;
signal mig_p2_cmd_ra            : std_logic_vector(14 downto 0);
signal mig_p2_cmd_ba            : std_logic_vector(2 downto 0);
signal mig_p2_cmd_ca            : std_logic_vector(11 downto 0);

signal mig_p2_cmd_instr         : std_logic_vector(2 downto 0);
signal mig_p2_cmd_bl            : std_logic_vector(5 downto 0);
signal mig_p2_cmd_empty         : std_logic;
signal mig_p2_cmd_full          : std_logic;

signal mig_p3_arb_en            : std_logic;
signal mig_p3_cmd_clk           : std_logic;
signal mig_p3_cmd_en            : std_logic;
signal mig_p3_cmd_ra            : std_logic_vector(14 downto 0);
signal mig_p3_cmd_ba            : std_logic_vector(2 downto 0);
signal mig_p3_cmd_ca            : std_logic_vector(11 downto 0);

signal mig_p3_cmd_instr         : std_logic_vector(2 downto 0);
signal mig_p3_cmd_bl            : std_logic_vector(5 downto 0);
signal mig_p3_cmd_empty         : std_logic;
signal mig_p3_cmd_full          : std_logic;

signal mig_p4_arb_en            : std_logic;
signal mig_p4_cmd_clk           : std_logic;
signal mig_p4_cmd_en            : std_logic;
signal mig_p4_cmd_ra            : std_logic_vector(14 downto 0);
signal mig_p4_cmd_ba            : std_logic_vector(2 downto 0);
signal mig_p4_cmd_ca            : std_logic_vector(11 downto 0);

signal mig_p4_cmd_instr         : std_logic_vector(2 downto 0);
signal mig_p4_cmd_bl            : std_logic_vector(5 downto 0);
signal mig_p4_cmd_empty         : std_logic;
signal mig_p4_cmd_full          : std_logic;

signal mig_p5_arb_en            : std_logic;
signal mig_p5_cmd_clk           : std_logic;
signal mig_p5_cmd_en            : std_logic;
signal mig_p5_cmd_ra            : std_logic_vector(14 downto 0);
signal mig_p5_cmd_ba            : std_logic_vector(2 downto 0);
signal mig_p5_cmd_ca            : std_logic_vector(11 downto 0);

signal mig_p5_cmd_instr         : std_logic_vector(2 downto 0);
signal mig_p5_cmd_bl            : std_logic_vector(5 downto 0);
signal mig_p5_cmd_empty         : std_logic;
signal mig_p5_cmd_full          : std_logic;

signal mig_p0_wr_clk            : std_logic;
signal mig_p0_rd_clk            : std_logic;
signal mig_p1_wr_clk            : std_logic;
signal mig_p1_rd_clk            : std_logic;
signal mig_p2_clk               : std_logic;
signal mig_p3_clk               : std_logic;
signal mig_p4_clk               : std_logic;
signal mig_p5_clk               : std_logic;

signal mig_p0_wr_en             : std_logic;
signal mig_p0_rd_en             : std_logic;
signal mig_p1_wr_en             : std_logic;
signal mig_p1_rd_en             : std_logic;
signal mig_p2_en                : std_logic;
signal mig_p3_en                : std_logic;
signal mig_p4_en                : std_logic;
signal mig_p5_en                : std_logic;

signal mig_p0_wr_data           : std_logic_vector(31 downto 0);
signal mig_p1_wr_data           : std_logic_vector(31 downto 0);
signal mig_p2_wr_data           : std_logic_vector(31 downto 0);
signal mig_p3_wr_data           : std_logic_vector(31 downto 0);
signal mig_p4_wr_data           : std_logic_vector(31 downto 0);
signal mig_p5_wr_data           : std_logic_vector(31 downto 0);

signal mig_p0_wr_mask           : std_logic_vector(C_P0_MASK_SIZE - 1 downto 0);
signal mig_p1_wr_mask           : std_logic_vector(C_P1_MASK_SIZE - 1 downto 0);
signal mig_p2_wr_mask           : std_logic_vector(3 downto 0);
signal mig_p3_wr_mask           : std_logic_vector(3 downto 0);
signal mig_p4_wr_mask           : std_logic_vector(3 downto 0);
signal mig_p5_wr_mask           : std_logic_vector(3 downto 0);

signal mig_p0_rd_data           : std_logic_vector(31 downto 0);
signal mig_p1_rd_data           : std_logic_vector(31 downto 0);
signal mig_p2_rd_data           : std_logic_vector(31 downto 0);
signal mig_p3_rd_data           : std_logic_vector(31 downto 0);
signal mig_p4_rd_data           : std_logic_vector(31 downto 0);
signal mig_p5_rd_data           : std_logic_vector(31 downto 0);

signal mig_p0_rd_overflow       : std_logic;
signal mig_p1_rd_overflow       : std_logic;
signal mig_p2_overflow          : std_logic;
signal mig_p3_overflow          : std_logic;

signal mig_p4_overflow          : std_logic;
signal mig_p5_overflow          : std_logic;

signal mig_p0_wr_underrun       : std_logic;
signal mig_p1_wr_underrun       : std_logic;
signal mig_p2_underrun          : std_logic;
signal mig_p3_underrun          : std_logic;
signal mig_p4_underrun          : std_logic;
signal mig_p5_underrun          : std_logic;

signal mig_p0_rd_error          : std_logic;
signal mig_p0_wr_error          : std_logic;
signal mig_p1_rd_error          : std_logic;
signal mig_p1_wr_error          : std_logic;
signal mig_p2_error             : std_logic;
signal mig_p3_error             : std_logic;
signal mig_p4_error             : std_logic;
signal mig_p5_error             : std_logic;

signal mig_p0_wr_count          : std_logic_vector(6 downto 0);
signal mig_p1_wr_count          : std_logic_vector(6 downto 0);
signal mig_p0_rd_count          : std_logic_vector(6 downto 0);
signal mig_p1_rd_count          : std_logic_vector(6 downto 0);

signal mig_p2_count             : std_logic_vector(6 downto 0);
signal mig_p3_count             : std_logic_vector(6 downto 0);
signal mig_p4_count             : std_logic_vector(6 downto 0);
signal mig_p5_count             : std_logic_vector(6 downto 0);

signal mig_p0_wr_full           : std_logic;
signal mig_p1_wr_full           : std_logic;

signal mig_p0_rd_empty          : std_logic;
signal mig_p1_rd_empty          : std_logic;
signal mig_p0_wr_empty          : std_logic;
signal mig_p1_wr_empty          : std_logic;
signal mig_p0_rd_full           : std_logic;
signal mig_p1_rd_full           : std_logic;
signal mig_p2_full              : std_logic;
signal mig_p3_full              : std_logic;
signal mig_p4_full              : std_logic;
signal mig_p5_full              : std_logic;
signal mig_p2_empty             : std_logic;
signal mig_p3_empty             : std_logic;
signal mig_p4_empty             : std_logic;
signal mig_p5_empty             : std_logic;

-- SELFREESH control signal for suspend feature
signal selfrefresh_mcb_enter    : std_logic;
signal selfrefresh_mcb_mode     : std_logic;
signal selfrefresh_mode_sig     : std_logic;

signal MCB_SYSRST : std_logic;
signal ioclk0  : std_logic;
signal ioclk90 : std_logic;
signal hard_done_cal       : std_logic;
signal uo_data_int         : std_logic_vector(7 downto 0);
signal uo_data_valid_int   : std_logic;
signal uo_cmd_ready_in_int : std_logic;
signal syn_uiclk_pll_lock  : std_logic;
signal int_sys_rst         : std_logic;

--testing
signal ioi_drp_update : std_logic;
signal aux_sdi_sdo : std_logic_vector(7 downto 0);


   signal mcb_recal                : std_logic;
   signal mcb_ui_read              : std_logic;
   signal mcb_ui_add               : std_logic;
   signal mcb_ui_cs                : std_logic;
   signal mcb_ui_clk               : std_logic;
   signal mcb_ui_sdi               : std_logic;
   signal mcb_ui_addr              : STD_LOGIC_vector(4 downto 0);
   signal mcb_ui_broadcast         : std_logic;
   signal mcb_ui_drp_update        : std_logic;
   signal mcb_ui_done_cal          : std_logic;
   signal mcb_ui_cmd               : std_logic;
   signal mcb_ui_cmd_in            : std_logic;
   signal mcb_ui_cmd_en            : std_logic;
   signal mcb_ui_dqcount           : std_logic_vector(3 downto 0);
   signal mcb_ui_dq_lower_dec      : std_logic;
   signal mcb_ui_dq_lower_inc      : std_logic;
   signal mcb_ui_dq_upper_dec      : std_logic;
   signal mcb_ui_dq_upper_inc      : std_logic;
   signal mcb_ui_udqs_inc          : std_logic;
   signal mcb_ui_udqs_dec          : std_logic;
   signal mcb_ui_ldqs_inc          : std_logic;
   signal mcb_ui_ldqs_dec          : std_logic;
   signal DONE_SOFTANDHARD_CAL     : std_logic;

   signal ck_shiftout0_1           : std_logic;
   signal ck_shiftout0_2           : std_logic;
   signal ck_shiftout1_3           : std_logic;
   signal ck_shiftout1_4           : std_logic;

   signal udm_oq                   : std_logic;
   signal udm_t                    : std_logic;
   signal ldm_oq                   : std_logic;
   signal ldm_t                    : std_logic;
   signal dqsp_oq                  : std_logic;
   signal dqsp_tq                  : std_logic;
   signal dqs_shiftout0_1          : std_logic;
   signal dqs_shiftout0_2          : std_logic;
   signal dqs_shiftout1_3          : std_logic;
   signal dqs_shiftout1_4          : std_logic;
   signal dqsn_oq                  : std_logic;
   signal dqsn_tq                  : std_logic;
   signal udqsp_oq                 : std_logic;
   signal udqsp_tq                 : std_logic;
   signal udqs_shiftout0_1         : std_logic;
   signal udqs_shiftout0_2         : std_logic;
   signal udqs_shiftout1_3         : std_logic;
   signal udqs_shiftout1_4         : std_logic;
   signal udqsn_oq                 : std_logic;
   signal udqsn_tq                 : std_logic;
   signal aux_sdi_out_dqsp         : std_logic;
   signal aux_sdi_out_udqsp        : std_logic;
   signal aux_sdi_out_udqsn        : std_logic;
   signal aux_sdi_out_0            : std_logic;
   signal aux_sdi_out_1            : std_logic;
   signal aux_sdi_out_2            : std_logic;
   signal aux_sdi_out_3            : std_logic;
   signal aux_sdi_out_5            : std_logic;
   signal aux_sdi_out_6            : std_logic;
   signal aux_sdi_out_7            : std_logic;
   signal aux_sdi_out_9            : std_logic;
   signal aux_sdi_out_10           : std_logic;
   signal aux_sdi_out_11           : std_logic;
   signal aux_sdi_out_12           : std_logic;
   signal aux_sdi_out_13           : std_logic;
   signal aux_sdi_out_14           : std_logic;
   signal aux_sdi_out_15           : std_logic;
   signal aux_sdi_out_8            : std_logic;
   signal aux_sdi_out_dqsn         : std_logic;
   signal aux_sdi_out_4            : std_logic;
   signal aux_sdi_out_udm          : std_logic;
   signal aux_sdi_out_ldm          : std_logic;
   signal uo_cal_start_int         : std_logic;
 
   signal cke_train                : std_logic;
   signal dq_oq                    : std_logic_vector(C_NUM_DQ_PINS-1 downto 0);
   signal dq_tq                    : std_logic_vector(C_NUM_DQ_PINS-1 downto 0);

   signal p0_wr_full_i             : std_logic;
   signal p0_rd_empty_i            : std_logic;
   signal p1_wr_full_i             : std_logic;
   signal p1_rd_empty_i            : std_logic;
   signal pllclk1                  : std_logic_vector(1 downto 0);
   signal pllce1                   : std_logic_vector(1 downto 0);
   signal uo_refrsh_flag_xhdl23    : std_logic;
   signal uo_sdo_xhdl24            : STD_LOGIC;
   signal Max_Value_Cal_Error      : std_logic;
   signal uo_done_cal_sig          : std_logic;
   signal wait_200us_counter       : std_logic_vector(15 downto 0);
   signal cke_train_reg            : std_logic;        
   signal wait_200us_done_r1       : std_logic;
   signal wait_200us_done_r2       : std_logic;
   signal syn1_sys_rst             : std_logic;
   signal syn2_sys_rst             : std_logic;
   signal selfrefresh_enter_r1     : std_logic;
   signal selfrefresh_enter_r2     : std_logic;
   signal selfrefresh_enter_r3     : std_logic;
   signal gated_pll_lock           : std_logic;
   signal soft_cal_selfrefresh_req : std_logic;
   signal normal_operation_window  : std_logic;

   attribute max_fanout            : string;
   attribute syn_maxfan            : integer;
   attribute max_fanout of int_sys_rst : signal is "1";
   attribute syn_maxfan of int_sys_rst : signal is 1;

begin
   uo_cmd_ready_in   <= uo_cmd_ready_in_int;
   uo_data_valid     <= uo_data_valid_int;
   uo_data           <= uo_data_int;
   uo_refrsh_flag    <= uo_refrsh_flag_xhdl23;
   uo_sdo            <= uo_sdo_xhdl24;

   p0_wr_full        <= p0_wr_full_i;
   p0_rd_empty       <= p0_rd_empty_i;
   p1_wr_full        <= p1_wr_full_i;
   p1_rd_empty       <= p1_rd_empty_i;
   ioclk0            <= sysclk_2x;
   ioclk90           <= sysclk_2x_180;
   pllclk1           <= (ioclk90 & ioclk0);
   pllce1            <= (pll_ce_90 & pll_ce_0);

   -- Assign the output signals with corresponding intermediate signals
   uo_done_cal       <= uo_done_cal_sig;

   -- Added 2/22 - Add flop to pll_lock status signal to improve timing
   process (ui_clk)
   begin
      if (ui_clk'event and ui_clk = '1') then      
        if ((selfrefresh_enter = '0') and (gated_pll_lock = '0')) then
         syn_uiclk_pll_lock <= pll_lock;
        end if;
      end if;
   end process;               

   -- logic to determine if Memory  is SELFREFRESH mode operation or NORMAL  mode.
   process (ui_clk)
   begin
      if (ui_clk'event and ui_clk = '1') then      
        if (sys_rst = '1') then  
           normal_operation_window <= '1';
        elsif (selfrefresh_enter_r2 = '1' or selfrefresh_mode_sig = '1') then
           normal_operation_window <= '0';
        elsif ((selfrefresh_enter_r2 = '0') and  (selfrefresh_mode_sig = '0')) then
           normal_operation_window <= '1';
        else
           normal_operation_window <= normal_operation_window;
        end if;
      end if;
   end process;   
   
   
   process(normal_operation_window,pll_lock,syn_uiclk_pll_lock)
   begin
     if (normal_operation_window = '1') then
      gated_pll_lock <= pll_lock;
     else
      gated_pll_lock <= syn_uiclk_pll_lock;
     end if;
   end process;

-- int_sys_rst will be asserted if pll lose lock during normal operation.
-- It uses the syn_uiclk_pll_lock version when it is entering suspend window , hence
-- reset will not be generated. 

   int_sys_rst <=  sys_rst or not(gated_pll_lock);

-- synchronize the selfrefresh_enter 
   process (ui_clk)
   begin
      if (ui_clk'event and ui_clk = '1') then      
        if (sys_rst = '1') then
          selfrefresh_enter_r1 <= '0';
          selfrefresh_enter_r2 <= '0';
          selfrefresh_enter_r3 <= '0';
        else
          selfrefresh_enter_r1 <= selfrefresh_enter;
          selfrefresh_enter_r2 <= selfrefresh_enter_r1;
          selfrefresh_enter_r3 <= selfrefresh_enter_r2;
        end if;
      end if;
    end process;



--  The soft_cal_selfrefresh siganl is conditioned before connect to mcb_soft_calibration module.
--  It will not deassert selfrefresh_mcb_enter to MCB until input pll_lock reestablished in system.
--  This is to ensure the IOI stables before issued a selfrefresh exit command to dram.
   process (ui_clk)
   begin
      if (ui_clk'event and ui_clk = '1') then      
        if (sys_rst = '1') then
          soft_cal_selfrefresh_req <= '0';
        elsif (selfrefresh_enter_r3 = '1') then
          soft_cal_selfrefresh_req <= '1';
        elsif (selfrefresh_enter_r3 = '0' and pll_lock = '1') then 
          soft_cal_selfrefresh_req <= '0';
        else
          soft_cal_selfrefresh_req <= soft_cal_selfrefresh_req;
        end if;
      end if;
    end process;
  

--Address Remapping
-- Byte Address remapping
-- 
-- Bank Address[x:0] & Row Address[x:0]  & Column Address[x:0]
-- column address remap for port 0

x16_addr        : if(C_NUM_DQ_PINS = 16) generate  --  port bus remapping sections for CONFIG 2   15,3,12
x16_addr_rbc    : if (C_MEM_ADDR_ORDER = "ROW_BANK_COLUMN") generate -- C_MEM_ADDR_ORDER = 0 : Bank Row  Column

-- port 0 address remapping
                
 x16_p0_a15     : if (C_MEM_ADDR_WIDTH = 15) generate
                   p0_cmd_ra <= p0_cmd_byte_addr(C_MEM_ADDR_WIDTH + C_MEM_BANKADDR_WIDTH + C_MEM_NUM_COL_BITS downto C_MEM_BANKADDR_WIDTH + C_MEM_NUM_COL_BITS + 1);                         
                end generate;

 x16_p0_a15_n : if (not(C_MEM_ADDR_WIDTH = 15)) generate
                   p0_cmd_ra <= (allzero(14 downto C_MEM_ADDR_WIDTH) &  p0_cmd_byte_addr(C_MEM_ADDR_WIDTH + C_MEM_BANKADDR_WIDTH + C_MEM_NUM_COL_BITS downto C_MEM_BANKADDR_WIDTH +  C_MEM_NUM_COL_BITS + 1)); 
                   end generate;
                      

 x16_p0_ba3 :       if (C_MEM_BANKADDR_WIDTH  = 3 ) generate --Bank
                        p0_cmd_ba <= p0_cmd_byte_addr( C_MEM_BANKADDR_WIDTH +  C_MEM_NUM_COL_BITS   downto   C_MEM_NUM_COL_BITS + 1);
                end generate;

 x16_p0_ba3_n :   if (not(C_MEM_BANKADDR_WIDTH  = 3 )) generate --Bank
                        p0_cmd_ba <=  (allzero(2 downto C_MEM_BANKADDR_WIDTH) & p0_cmd_byte_addr(C_MEM_BANKADDR_WIDTH +   C_MEM_NUM_COL_BITS   downto  + C_MEM_NUM_COL_BITS + 1));
                end generate;

                
 x16_p0_ca12 :     if (C_MEM_NUM_COL_BITS = 12)  generate --Column
                        p0_cmd_ca <= p0_cmd_byte_addr(C_MEM_NUM_COL_BITS downto 1);
                end generate;

 x16_p0_ca12_n :     if (not(C_MEM_NUM_COL_BITS = 12))  generate --Column
                        p0_cmd_ca <=  (allzero(12 downto C_MEM_NUM_COL_BITS + 1) & p0_cmd_byte_addr(C_MEM_NUM_COL_BITS downto 1));
                end generate;

-- port 1 address remapping
  
 x16_p1_a15     : if (C_MEM_ADDR_WIDTH = 15) generate  --Row  
                        p1_cmd_ra <=  p1_cmd_byte_addr(C_MEM_ADDR_WIDTH + C_MEM_BANKADDR_WIDTH + C_MEM_NUM_COL_BITS   downto C_MEM_BANKADDR_WIDTH + C_MEM_NUM_COL_BITS + 1);                         
                end generate;

 x16_p1_a15_n : if (not(C_MEM_ADDR_WIDTH = 15)) generate --Row  
                        p1_cmd_ra <= (allzero(14 downto C_MEM_ADDR_WIDTH) &  p1_cmd_byte_addr(C_MEM_ADDR_WIDTH + C_MEM_BANKADDR_WIDTH + C_MEM_NUM_COL_BITS   downto C_MEM_BANKADDR_WIDTH +  C_MEM_NUM_COL_BITS + 1));                            
                   end generate;
                      

 x16_p1_ba3 :       if (C_MEM_BANKADDR_WIDTH  = 3 ) generate --Bank
                        p1_cmd_ba <= p1_cmd_byte_addr(C_MEM_BANKADDR_WIDTH +  C_MEM_NUM_COL_BITS   downto   C_MEM_NUM_COL_BITS + 1);
                end generate;

 x16_p1_ba3_n :   if (not(C_MEM_BANKADDR_WIDTH  = 3 )) generate --Bank
                        p1_cmd_ba <= (allzero(2 downto C_MEM_BANKADDR_WIDTH) & p1_cmd_byte_addr(C_MEM_BANKADDR_WIDTH +   C_MEM_NUM_COL_BITS   downto  + C_MEM_NUM_COL_BITS + 1));

                end generate;

                
 x16_p1_ca12 :     if (C_MEM_NUM_COL_BITS = 12)  generate --Column
                        p1_cmd_ca <= p1_cmd_byte_addr(C_MEM_NUM_COL_BITS downto 1);

                end generate;

 x16_p1_ca12_n :     if (not(C_MEM_NUM_COL_BITS = 12))  generate --Column
                        p1_cmd_ca <= (allzero(12 downto C_MEM_NUM_COL_BITS + 1) & p1_cmd_byte_addr(C_MEM_NUM_COL_BITS downto 1));

                end generate;

 -- port 2 address remapping
 x16_p2_a15     : if (C_MEM_ADDR_WIDTH = 15) generate --Row  
                         p2_cmd_ra <= p2_cmd_byte_addr(C_MEM_ADDR_WIDTH + C_MEM_BANKADDR_WIDTH + C_MEM_NUM_COL_BITS   downto C_MEM_BANKADDR_WIDTH + C_MEM_NUM_COL_BITS + 1);                         
                end generate;

 x16_p2_a15_n : if (not(C_MEM_ADDR_WIDTH = 15)) generate --Row  
                         p2_cmd_ra <= (allzero(14 downto C_MEM_ADDR_WIDTH) &  p2_cmd_byte_addr (C_MEM_ADDR_WIDTH + C_MEM_BANKADDR_WIDTH + C_MEM_NUM_COL_BITS   downto C_MEM_BANKADDR_WIDTH +  C_MEM_NUM_COL_BITS + 1));                         
                   end generate;
                      

 x16_p2_ba3 :       if (C_MEM_BANKADDR_WIDTH  = 3 ) generate --Bank
                         p2_cmd_ba <= p2_cmd_byte_addr(C_MEM_BANKADDR_WIDTH +  C_MEM_NUM_COL_BITS   downto   C_MEM_NUM_COL_BITS + 1);
                end generate;

 x16_p2_ba3_n :   if (not(C_MEM_BANKADDR_WIDTH  = 3 )) generate --Bank
                         p2_cmd_ba <= (allzero(2 downto C_MEM_BANKADDR_WIDTH) & p2_cmd_byte_addr(C_MEM_BANKADDR_WIDTH +   C_MEM_NUM_COL_BITS   downto   C_MEM_NUM_COL_BITS + 1));
                end generate;

                
 x16_p2_ca12 :     if (C_MEM_NUM_COL_BITS = 12)  generate --Column
                         p2_cmd_ca <= p2_cmd_byte_addr(C_MEM_NUM_COL_BITS downto 1);

                end generate;

 x16_p2_ca12_n :     if (not(C_MEM_NUM_COL_BITS = 12))  generate --Column
                         p2_cmd_ca <= (allzero(12 downto C_MEM_NUM_COL_BITS + 1) & p2_cmd_byte_addr(C_MEM_NUM_COL_BITS downto 1));

                end generate;
                

-- port 3 address remapping
 x16_p3_a15     : if (C_MEM_ADDR_WIDTH = 15) generate --Row  
                         p3_cmd_ra <= p3_cmd_byte_addr(C_MEM_ADDR_WIDTH + C_MEM_BANKADDR_WIDTH + C_MEM_NUM_COL_BITS   downto C_MEM_BANKADDR_WIDTH + C_MEM_NUM_COL_BITS + 1);                         

                end generate;

 x16_p3_a15_n : if (not(C_MEM_ADDR_WIDTH = 15)) generate --Row  
                        p3_cmd_ra <= (allzero(14 downto C_MEM_ADDR_WIDTH) &  p3_cmd_byte_addr(C_MEM_ADDR_WIDTH + C_MEM_BANKADDR_WIDTH + C_MEM_NUM_COL_BITS   downto C_MEM_BANKADDR_WIDTH +  C_MEM_NUM_COL_BITS + 1));                         
                   end generate;
                      

 x16_p3_ba3 :       if (C_MEM_BANKADDR_WIDTH  = 3 ) generate --Bank
                         p3_cmd_ba <= p3_cmd_byte_addr(C_MEM_BANKADDR_WIDTH +  C_MEM_NUM_COL_BITS   downto   C_MEM_NUM_COL_BITS + 1);

                end generate;

 x16_p3_ba3_n :   if (not(C_MEM_BANKADDR_WIDTH  = 3 )) generate --Bank
                         p3_cmd_ba <= (allzero(2 downto C_MEM_BANKADDR_WIDTH) & p3_cmd_byte_addr(C_MEM_BANKADDR_WIDTH +   C_MEM_NUM_COL_BITS   downto  + C_MEM_NUM_COL_BITS + 1));

                end generate;

                
 x16_p3_ca12 :     if (C_MEM_NUM_COL_BITS = 12)  generate --Column
                        p3_cmd_ca <= p3_cmd_byte_addr(C_MEM_NUM_COL_BITS downto 1);

                end generate;

 x16_p3_ca12_n :     if (not(C_MEM_NUM_COL_BITS = 12))  generate --Column
                        p3_cmd_ca <= (allzero(12 downto C_MEM_NUM_COL_BITS +1 ) & p3_cmd_byte_addr(C_MEM_NUM_COL_BITS downto 1));
                end generate;
                
                


 -- port 4 address remapping
                
  x16_p4_a15    : if (C_MEM_ADDR_WIDTH = 15) generate --Row  
                        p4_cmd_ra <= p4_cmd_byte_addr(C_MEM_ADDR_WIDTH + C_MEM_BANKADDR_WIDTH + C_MEM_NUM_COL_BITS   downto C_MEM_BANKADDR_WIDTH + C_MEM_NUM_COL_BITS + 1);                         

                end generate;

 x16_p4_a15_n : if (not(C_MEM_ADDR_WIDTH = 15)) generate --Row  
                        p4_cmd_ra <= (allzero(14 downto C_MEM_ADDR_WIDTH) &  p4_cmd_byte_addr(C_MEM_ADDR_WIDTH + C_MEM_BANKADDR_WIDTH + C_MEM_NUM_COL_BITS   downto C_MEM_BANKADDR_WIDTH +  C_MEM_NUM_COL_BITS + 1));                         
                   end generate;
                      

 x16_p4_ba3 :       if (C_MEM_BANKADDR_WIDTH  = 3 ) generate --Bank
                        p4_cmd_ba <= p4_cmd_byte_addr(C_MEM_BANKADDR_WIDTH +  C_MEM_NUM_COL_BITS   downto   C_MEM_NUM_COL_BITS + 1);
                end generate;

 x16_p4_ba3_n :   if (not(C_MEM_BANKADDR_WIDTH  = 3 )) generate --Bank
                        p4_cmd_ba <= (allzero(2 downto C_MEM_BANKADDR_WIDTH) & p4_cmd_byte_addr(C_MEM_BANKADDR_WIDTH +   C_MEM_NUM_COL_BITS   downto  C_MEM_NUM_COL_BITS + 1));
                end generate;

                
 x16_p4_ca12 :     if (C_MEM_NUM_COL_BITS = 12)  generate --Column
                        p4_cmd_ca <= p4_cmd_byte_addr(C_MEM_NUM_COL_BITS downto 1);

                end generate;

 x16_p4_ca12_n :     if (not(C_MEM_NUM_COL_BITS = 12))  generate --Column
                        p4_cmd_ca <= (allzero(12 downto C_MEM_NUM_COL_BITS +1)& p4_cmd_byte_addr(C_MEM_NUM_COL_BITS downto 1));
                end generate;
               


-- port 5 address remapping
  x16_p5_a15    : if (C_MEM_ADDR_WIDTH = 15) generate --Row  
                          p5_cmd_ra <= p5_cmd_byte_addr(C_MEM_ADDR_WIDTH + C_MEM_BANKADDR_WIDTH + C_MEM_NUM_COL_BITS   downto C_MEM_BANKADDR_WIDTH + C_MEM_NUM_COL_BITS + 1);                         
                end generate;

 x16_p5_a15_n : if (not(C_MEM_ADDR_WIDTH = 15)) generate --Row  
                         p5_cmd_ra <= (allzero(14 downto C_MEM_ADDR_WIDTH) &  p5_cmd_byte_addr(C_MEM_ADDR_WIDTH + C_MEM_BANKADDR_WIDTH + C_MEM_NUM_COL_BITS   downto C_MEM_BANKADDR_WIDTH +  C_MEM_NUM_COL_BITS + 1));                         
                   end generate;
                      

 x16_p5_ba3 :       if (C_MEM_BANKADDR_WIDTH  = 3 ) generate --Bank
                        p5_cmd_ba <= p5_cmd_byte_addr(C_MEM_BANKADDR_WIDTH +  C_MEM_NUM_COL_BITS   downto   C_MEM_NUM_COL_BITS + 1);
                end generate;

 x16_p5_ba3_n :   if (not(C_MEM_BANKADDR_WIDTH  = 3 )) generate --Bank
                         p5_cmd_ba <= (allzero(2 downto C_MEM_BANKADDR_WIDTH) & p5_cmd_byte_addr(C_MEM_BANKADDR_WIDTH +   C_MEM_NUM_COL_BITS   downto  + C_MEM_NUM_COL_BITS + 1));
                end generate;

                
 x16_p5_ca12 :     if (C_MEM_NUM_COL_BITS = 12)  generate --Column
                        p5_cmd_ca <= p5_cmd_byte_addr(C_MEM_NUM_COL_BITS downto 1);
                end generate;

 x16_p5_ca12_n :     if (not(C_MEM_NUM_COL_BITS = 12))  generate --Column
                        p5_cmd_ca <= (allzero(12 downto C_MEM_NUM_COL_BITS+1) & p5_cmd_byte_addr(C_MEM_NUM_COL_BITS downto 1));
                end generate;
end generate;   --x16_addr_rbc            
                
x16_addr_rbc_n  : if (not(C_MEM_ADDR_ORDER = "ROW_BANK_COLUMN")) generate 
                
                
 -- port 0 address remapping

x16_rbc_n_p0_ba3 :  if (C_MEM_BANKADDR_WIDTH  = 3 ) generate  --Bank
                        p0_cmd_ba <= p0_cmd_byte_addr(C_MEM_BANKADDR_WIDTH + C_MEM_ADDR_WIDTH +  C_MEM_NUM_COL_BITS  downto C_MEM_ADDR_WIDTH + C_MEM_NUM_COL_BITS + 1);
               end generate;

x16_rbc_n_p0_ba3_n :  if (not(C_MEM_BANKADDR_WIDTH  = 3 )) generate  --Bank
                        p0_cmd_ba <= (allzero(2 downto C_MEM_BANKADDR_WIDTH) & p0_cmd_byte_addr(C_MEM_BANKADDR_WIDTH + C_MEM_ADDR_WIDTH +  C_MEM_NUM_COL_BITS  downto C_MEM_ADDR_WIDTH + C_MEM_NUM_COL_BITS + 1));
               end generate;

x16_rbc_n_p0_a15 :  if (C_MEM_ADDR_WIDTH  = 15 ) generate  --row
                        p0_cmd_ra <= p0_cmd_byte_addr(C_MEM_ADDR_WIDTH + C_MEM_NUM_COL_BITS   downto C_MEM_NUM_COL_BITS + 1);                         
               end generate;

x16_rbc_n_p0_a15_n :  if (not(C_MEM_ADDR_WIDTH  = 15 )) generate  --row
                        p0_cmd_ra <= (allzero(14 downto C_MEM_ADDR_WIDTH) &  p0_cmd_byte_addr(C_MEM_ADDR_WIDTH + C_MEM_NUM_COL_BITS   downto C_MEM_NUM_COL_BITS + 1));                         
               end generate;

x16_rbc_n_p0_c12 :  if (C_MEM_NUM_COL_BITS  = 12 ) generate  --column
                        p0_cmd_ca <= p0_cmd_byte_addr(C_MEM_NUM_COL_BITS downto 1);

               end generate;

x16_rbc_n_p0_c12_n :  if (not(C_MEM_NUM_COL_BITS  = 12 )) generate  --column
                        p0_cmd_ca <= (allzero(12 downto C_MEM_NUM_COL_BITS+1)& p0_cmd_byte_addr(C_MEM_NUM_COL_BITS downto 1));
               end generate;
                

                


-- port 1 address remapping
 x16_rbc_n_p1_ba3 :  if (C_MEM_BANKADDR_WIDTH  = 3 ) generate  --Bank
                        p1_cmd_ba <= p1_cmd_byte_addr(C_MEM_BANKADDR_WIDTH + C_MEM_ADDR_WIDTH +  C_MEM_NUM_COL_BITS  downto C_MEM_ADDR_WIDTH + C_MEM_NUM_COL_BITS + 1);
               end generate;

x16_rbc_n_p1_ba3_n :  if (not(C_MEM_BANKADDR_WIDTH  = 3 )) generate  --Bank
                        p1_cmd_ba <= (allzero(2 downto C_MEM_BANKADDR_WIDTH) & p1_cmd_byte_addr(C_MEM_BANKADDR_WIDTH + C_MEM_ADDR_WIDTH +  C_MEM_NUM_COL_BITS  downto C_MEM_ADDR_WIDTH + C_MEM_NUM_COL_BITS + 1));
               end generate;

x16_rbc_n_p1_a15 :  if (C_MEM_ADDR_WIDTH  = 15 ) generate  --row
                        p1_cmd_ra <= p1_cmd_byte_addr(C_MEM_ADDR_WIDTH + C_MEM_NUM_COL_BITS   downto C_MEM_NUM_COL_BITS + 1);                         
               end generate;

x16_rbc_n_p1_a15_n :  if (not(C_MEM_ADDR_WIDTH  = 15 )) generate  --row
                        p1_cmd_ra <= (allzero(14 downto C_MEM_ADDR_WIDTH) &  p1_cmd_byte_addr(C_MEM_ADDR_WIDTH + C_MEM_NUM_COL_BITS   downto C_MEM_NUM_COL_BITS + 1));                         
               end generate;

x16_rbc_n_p1_c12 :  if (C_MEM_NUM_COL_BITS  = 12 ) generate  --column
                        p1_cmd_ca <= p1_cmd_byte_addr(C_MEM_NUM_COL_BITS downto 1);
               end generate;

x16_rbc_n_p1_c12_n :  if (not(C_MEM_NUM_COL_BITS  = 12 )) generate  --column
                        p1_cmd_ca <= (allzero(12 downto C_MEM_NUM_COL_BITS+1) & p1_cmd_byte_addr(C_MEM_NUM_COL_BITS  downto 1));
               end generate;



 -- port 2 address remapping
x16_rbc_n_p2_ba3 :  if (C_MEM_BANKADDR_WIDTH  = 3 ) generate  --Bank
                        p2_cmd_ba <= p2_cmd_byte_addr(C_MEM_BANKADDR_WIDTH + C_MEM_ADDR_WIDTH +  C_MEM_NUM_COL_BITS   downto C_MEM_ADDR_WIDTH + C_MEM_NUM_COL_BITS + 1);
               end generate;

x16_rbc_n_p2_ba3_n :  if (not(C_MEM_BANKADDR_WIDTH  = 3 )) generate  --Bank
                        p2_cmd_ba <= (allzero(2  downto C_MEM_BANKADDR_WIDTH) & p2_cmd_byte_addr(C_MEM_BANKADDR_WIDTH + C_MEM_ADDR_WIDTH +  C_MEM_NUM_COL_BITS   downto C_MEM_ADDR_WIDTH + C_MEM_NUM_COL_BITS + 1));

               end generate;

x16_rbc_n_p2_a15 :  if (C_MEM_ADDR_WIDTH  = 15 ) generate  --row
                        p2_cmd_ra <= p2_cmd_byte_addr(C_MEM_ADDR_WIDTH + C_MEM_NUM_COL_BITS    downto C_MEM_NUM_COL_BITS + 1);                         

               end generate;

x16_rbc_n_p2_a15_n :  if (not(C_MEM_ADDR_WIDTH  = 15 )) generate  --row
                        p2_cmd_ra <= (allzero(14  downto C_MEM_ADDR_WIDTH) &  p2_cmd_byte_addr(C_MEM_ADDR_WIDTH + C_MEM_NUM_COL_BITS    downto C_MEM_NUM_COL_BITS + 1));    
               end generate;

x16_rbc_n_p2_c12 :  if (C_MEM_NUM_COL_BITS  = 12 ) generate  --column
                        p2_cmd_ca <= p2_cmd_byte_addr(C_MEM_NUM_COL_BITS  downto 1);

               end generate;

x16_rbc_n_p2_c12_n :  if (not(C_MEM_NUM_COL_BITS  = 12 )) generate  --column
                        p2_cmd_ca <= (allzero( 12 downto C_MEM_NUM_COL_BITS +1)& p2_cmd_byte_addr(C_MEM_NUM_COL_BITS  downto 1));

               end generate;


 -- port 3 address remapping
x16_rbc_n_p3_ba3 :  if (C_MEM_BANKADDR_WIDTH  = 3 ) generate  --Bank
                        p3_cmd_ba <= p3_cmd_byte_addr(C_MEM_BANKADDR_WIDTH + C_MEM_ADDR_WIDTH +  C_MEM_NUM_COL_BITS   downto C_MEM_ADDR_WIDTH + C_MEM_NUM_COL_BITS + 1);

               end generate;

x16_rbc_n_p3_ba3_n :  if (not(C_MEM_BANKADDR_WIDTH  = 3 )) generate  --Bank
                        p3_cmd_ba <= (allzero(2  downto C_MEM_BANKADDR_WIDTH) & p3_cmd_byte_addr(C_MEM_BANKADDR_WIDTH + C_MEM_ADDR_WIDTH +  C_MEM_NUM_COL_BITS   downto C_MEM_ADDR_WIDTH + C_MEM_NUM_COL_BITS + 1));

               end generate;

x16_rbc_n_p3_a15 :  if (C_MEM_ADDR_WIDTH  = 15 ) generate  --row
                        p3_cmd_ra <= p3_cmd_byte_addr(C_MEM_ADDR_WIDTH + C_MEM_NUM_COL_BITS    downto C_MEM_NUM_COL_BITS + 1);                         

               end generate;

x16_rbc_n_p3_a15_n :  if (not(C_MEM_ADDR_WIDTH  = 15 )) generate  --row
                        p3_cmd_ra <= (allzero(14  downto C_MEM_ADDR_WIDTH) &  p3_cmd_byte_addr(C_MEM_ADDR_WIDTH + C_MEM_NUM_COL_BITS    downto C_MEM_NUM_COL_BITS + 1));                         

               end generate;

x16_rbc_n_p3_c12 :  if (C_MEM_NUM_COL_BITS  = 12 ) generate  --column
                        p3_cmd_ca <= p3_cmd_byte_addr(C_MEM_NUM_COL_BITS  downto 1);

               end generate;

x16_rbc_n_p3_c12_n :  if (not(C_MEM_NUM_COL_BITS  = 12 )) generate  --column
                        p3_cmd_ca <= (allzero(12 downto C_MEM_NUM_COL_BITS +1)& p3_cmd_byte_addr(C_MEM_NUM_COL_BITS downto 1));

               end generate;


 -- port 4 address remapping
x16_rbc_n_p4_ba3 :  if (C_MEM_BANKADDR_WIDTH  = 3 ) generate  --Bank
                        p4_cmd_ba <= p4_cmd_byte_addr(C_MEM_BANKADDR_WIDTH + C_MEM_ADDR_WIDTH +  C_MEM_NUM_COL_BITS  downto C_MEM_ADDR_WIDTH + C_MEM_NUM_COL_BITS + 1);

               end generate;

x16_rbc_n_p4_ba3_n :  if (not(C_MEM_BANKADDR_WIDTH  = 3 )) generate  --Bank
                        p4_cmd_ba <= (allzero(2 downto C_MEM_BANKADDR_WIDTH) & p4_cmd_byte_addr(C_MEM_BANKADDR_WIDTH + C_MEM_ADDR_WIDTH +  C_MEM_NUM_COL_BITS  downto C_MEM_ADDR_WIDTH + C_MEM_NUM_COL_BITS + 1));

               end generate;

x16_rbc_n_p4_a15 :  if (C_MEM_ADDR_WIDTH  = 15 ) generate  --row
                        p4_cmd_ra <= p4_cmd_byte_addr(C_MEM_ADDR_WIDTH + C_MEM_NUM_COL_BITS   downto C_MEM_NUM_COL_BITS + 1);                         

               end generate;

x16_rbc_n_p4_a15_n :  if (not(C_MEM_ADDR_WIDTH  = 15 )) generate  --row
                        p4_cmd_ra <= (allzero(14 downto C_MEM_ADDR_WIDTH) &  p4_cmd_byte_addr(C_MEM_ADDR_WIDTH + C_MEM_NUM_COL_BITS   downto C_MEM_NUM_COL_BITS + 1));                         
               end generate;

x16_rbc_n_p4_c12 :  if (C_MEM_NUM_COL_BITS  = 12 ) generate  --column
                        p4_cmd_ca <= p4_cmd_byte_addr(C_MEM_NUM_COL_BITS downto 1);

               end generate;

x16_rbc_n_p4_c12_n :  if (not(C_MEM_NUM_COL_BITS  = 12 )) generate  --column
                        p4_cmd_ca <= (allzero(12 downto C_MEM_NUM_COL_BITS +1) & p4_cmd_byte_addr(C_MEM_NUM_COL_BITS downto 1));

               end generate;

 -- port 5 address remapping
x16_rbc_n_p5_ba3 :  if (C_MEM_BANKADDR_WIDTH  = 3 ) generate  --Bank
                        p5_cmd_ba <= p5_cmd_byte_addr(C_MEM_BANKADDR_WIDTH + C_MEM_ADDR_WIDTH +  C_MEM_NUM_COL_BITS  downto C_MEM_ADDR_WIDTH + C_MEM_NUM_COL_BITS + 1);

               end generate;

x16_rbc_n_p5_ba3_n :  if (not(C_MEM_BANKADDR_WIDTH  = 3 )) generate  --Bank
                        p5_cmd_ba <= (allzero(2 downto C_MEM_BANKADDR_WIDTH) & p5_cmd_byte_addr(C_MEM_BANKADDR_WIDTH + C_MEM_ADDR_WIDTH +  C_MEM_NUM_COL_BITS  downto C_MEM_ADDR_WIDTH + C_MEM_NUM_COL_BITS + 1));

               end generate;

x16_rbc_n_p5_a15 :  if (C_MEM_ADDR_WIDTH  = 15 ) generate  --row
                        p5_cmd_ra <= p5_cmd_byte_addr(C_MEM_ADDR_WIDTH + C_MEM_NUM_COL_BITS   downto C_MEM_NUM_COL_BITS + 1);                         
               end generate;

x16_rbc_n_p5_a15_n :  if (not(C_MEM_ADDR_WIDTH  = 15 )) generate  --row
                        p5_cmd_ra <= (allzero(14 downto C_MEM_ADDR_WIDTH) &  p5_cmd_byte_addr(C_MEM_ADDR_WIDTH + C_MEM_NUM_COL_BITS   downto C_MEM_NUM_COL_BITS + 1));                         

               end generate;

x16_rbc_n_p5_c12 :  if (C_MEM_NUM_COL_BITS  = 12 ) generate  --column
                        p5_cmd_ca <= p5_cmd_byte_addr(C_MEM_NUM_COL_BITS downto 1);

               end generate;

x16_rbc_n_p5_c12_n :  if (not(C_MEM_NUM_COL_BITS  = 12 )) generate  --column
                        p5_cmd_ca <= (allzero(12 downto C_MEM_NUM_COL_BITS +1) & p5_cmd_byte_addr(C_MEM_NUM_COL_BITS downto 1));

               end generate;
 end generate;--x16_addr_rbc_n
end generate; --x16_addr






x8_addr : if(C_NUM_DQ_PINS = 8) generate
x8_addr_rbc     : if (C_MEM_ADDR_ORDER = "ROW_BANK_COLUMN") generate 
-- port 0 address remapping

x8_p0_a15       : if (C_MEM_ADDR_WIDTH = 15) generate -- Row
                           p0_cmd_ra <= p0_cmd_byte_addr(C_MEM_ADDR_WIDTH + C_MEM_BANKADDR_WIDTH +  C_MEM_NUM_COL_BITS - 1   downto C_MEM_BANKADDR_WIDTH +  C_MEM_NUM_COL_BITS );

                end generate;

 x8_p0_a15_n : if (not(C_MEM_ADDR_WIDTH = 15)) generate --Row
                            p0_cmd_ra <= (allzero(14  downto C_MEM_ADDR_WIDTH) & p0_cmd_byte_addr(C_MEM_ADDR_WIDTH + C_MEM_BANKADDR_WIDTH +  C_MEM_NUM_COL_BITS - 1   downto C_MEM_BANKADDR_WIDTH +  C_MEM_NUM_COL_BITS ));

                   end generate;
                      

 x8_p0_ba3 :       if (C_MEM_BANKADDR_WIDTH  = 3 ) generate --Bank
                           p0_cmd_ba <= p0_cmd_byte_addr(C_MEM_BANKADDR_WIDTH +  C_MEM_NUM_COL_BITS - 1  downto  C_MEM_NUM_COL_BITS );  --14,3,10

                end generate;

 x8_p0_ba3_n :   if (not(C_MEM_BANKADDR_WIDTH  = 3 )) generate --Bank
                           p0_cmd_ba <= (allzero(2  downto C_MEM_BANKADDR_WIDTH)&  
                                   p0_cmd_byte_addr(C_MEM_BANKADDR_WIDTH +  C_MEM_NUM_COL_BITS - 1  downto C_MEM_NUM_COL_BITS ));  --14,3,10

                end generate;

                
 x8_p0_ca12 :     if (C_MEM_NUM_COL_BITS = 12)  generate --Column
                            p0_cmd_ca(11 downto 0) <= p0_cmd_byte_addr(C_MEM_NUM_COL_BITS - 1  downto  0);

                end generate;

 x8_p0_ca12_n :     if (not(C_MEM_NUM_COL_BITS = 12))  generate --Column
                            p0_cmd_ca(11 downto 0) <= (allzero(11  downto  C_MEM_NUM_COL_BITS) & p0_cmd_byte_addr(C_MEM_NUM_COL_BITS - 1  downto  0));

                end generate;


                 
                 
-- port 1 address remapping
 x8_p1_a15      : if (C_MEM_ADDR_WIDTH = 15) generate -- Row
                            p1_cmd_ra <= p1_cmd_byte_addr(C_MEM_ADDR_WIDTH + C_MEM_BANKADDR_WIDTH +  C_MEM_NUM_COL_BITS - 1   downto  C_MEM_BANKADDR_WIDTH +  C_MEM_NUM_COL_BITS );

                end generate;

 x8_p1_a15_n : if (not(C_MEM_ADDR_WIDTH = 15)) generate --Row
                            p1_cmd_ra <= (allzero(14  downto  C_MEM_ADDR_WIDTH) & p1_cmd_byte_addr(C_MEM_ADDR_WIDTH + C_MEM_BANKADDR_WIDTH +  C_MEM_NUM_COL_BITS - 1   downto  C_MEM_BANKADDR_WIDTH +  C_MEM_NUM_COL_BITS ));

                   end generate;
                      

 x8_p1_ba3 :       if (C_MEM_BANKADDR_WIDTH  = 3 ) generate --Bank
                            p1_cmd_ba <= p1_cmd_byte_addr(C_MEM_BANKADDR_WIDTH +  C_MEM_NUM_COL_BITS - 1  downto   C_MEM_NUM_COL_BITS );  --14,3,10

                end generate;

 x8_p1_ba3_n :   if (not(C_MEM_BANKADDR_WIDTH  = 3 )) generate --Bank
                            p1_cmd_ba <= (allzero(2  downto  C_MEM_BANKADDR_WIDTH)&  
                                   p1_cmd_byte_addr(C_MEM_BANKADDR_WIDTH +  C_MEM_NUM_COL_BITS - 1  downto  C_MEM_NUM_COL_BITS ));  --14,3,10

                end generate;

                
 x8_p1_ca12 :     if (C_MEM_NUM_COL_BITS = 12)  generate --Column
                            p1_cmd_ca(11 downto 0) <= p1_cmd_byte_addr(C_MEM_NUM_COL_BITS - 1  downto  0);

                end generate;

 x8_p1_ca12_n :     if (not(C_MEM_NUM_COL_BITS = 12))  generate --Column
                           p1_cmd_ca(11 downto 0) <= (allzero(11  downto  C_MEM_NUM_COL_BITS) & p1_cmd_byte_addr(C_MEM_NUM_COL_BITS - 1  downto  0));

                end generate;

                 
                
 -- port 2 address remapping
  x8_p2_a15     : if (C_MEM_ADDR_WIDTH = 15) generate -- Row
                             p2_cmd_ra <= p2_cmd_byte_addr(C_MEM_ADDR_WIDTH + C_MEM_BANKADDR_WIDTH +  C_MEM_NUM_COL_BITS - 1   downto  C_MEM_BANKADDR_WIDTH +  C_MEM_NUM_COL_BITS );

                end generate;

 x8_p2_a15_n : if (not(C_MEM_ADDR_WIDTH = 15)) generate --Row
                            p2_cmd_ra <= (allzero(14  downto  C_MEM_ADDR_WIDTH) & p2_cmd_byte_addr(C_MEM_ADDR_WIDTH + C_MEM_BANKADDR_WIDTH +  C_MEM_NUM_COL_BITS - 1   downto  C_MEM_BANKADDR_WIDTH +  C_MEM_NUM_COL_BITS ));

                   end generate;
                      

 x8_p2_ba3 :       if (C_MEM_BANKADDR_WIDTH  = 3 ) generate --Bank
                            p2_cmd_ba <= p2_cmd_byte_addr(C_MEM_BANKADDR_WIDTH +  C_MEM_NUM_COL_BITS - 1  downto   C_MEM_NUM_COL_BITS );  --14,3,10

                end generate;

 x8_p2_ba3_n :   if (not(C_MEM_BANKADDR_WIDTH  = 3 )) generate --Bank
                            p2_cmd_ba <= (allzero(2  downto  C_MEM_BANKADDR_WIDTH)&  
                                   p2_cmd_byte_addr(C_MEM_BANKADDR_WIDTH +  C_MEM_NUM_COL_BITS - 1  downto  C_MEM_NUM_COL_BITS ));  --14,2,10  ***

                end generate;

                
 x8_p2_ca12 :     if (C_MEM_NUM_COL_BITS = 12)  generate --Column
                            p2_cmd_ca(11 downto 0) <= p2_cmd_byte_addr(C_MEM_NUM_COL_BITS - 1  downto  0);

                end generate;

 x8_p2_ca12_n :     if (not(C_MEM_NUM_COL_BITS = 12))  generate --Column
                            p2_cmd_ca(11 downto 0) <= (allzero(11  downto  C_MEM_NUM_COL_BITS) & p2_cmd_byte_addr(C_MEM_NUM_COL_BITS - 1  downto  0));

                end generate;

                 


--   port 3 address remapping
 x8_p3_a15      : if (C_MEM_ADDR_WIDTH = 15) generate -- Row
                            p3_cmd_ra <= p3_cmd_byte_addr(C_MEM_ADDR_WIDTH + C_MEM_BANKADDR_WIDTH +  C_MEM_NUM_COL_BITS - 1   downto  C_MEM_BANKADDR_WIDTH +  C_MEM_NUM_COL_BITS );

                end generate;

 x8_p3_a15_n : if (not(C_MEM_ADDR_WIDTH = 15)) generate --Row
                            p3_cmd_ra <= (allzero(14  downto  C_MEM_ADDR_WIDTH) & p3_cmd_byte_addr(C_MEM_ADDR_WIDTH + C_MEM_BANKADDR_WIDTH +  C_MEM_NUM_COL_BITS - 1   downto  C_MEM_BANKADDR_WIDTH +  C_MEM_NUM_COL_BITS ));

                   end generate;
                      

 x8_p3_ba3 :       if (C_MEM_BANKADDR_WIDTH  = 3 ) generate --Bank
                            p3_cmd_ba <= p3_cmd_byte_addr(C_MEM_BANKADDR_WIDTH +  C_MEM_NUM_COL_BITS - 1  downto   C_MEM_NUM_COL_BITS );  --14,3,10

                end generate;

 x8_p3_ba3_n :   if (not(C_MEM_BANKADDR_WIDTH  = 3 )) generate --Bank
                            p3_cmd_ba <= (allzero(2  downto  C_MEM_BANKADDR_WIDTH)&  
                                   p3_cmd_byte_addr(C_MEM_BANKADDR_WIDTH +  C_MEM_NUM_COL_BITS - 1  downto  C_MEM_NUM_COL_BITS ));  --14,3,10

                end generate;

                
 x8_p3_ca12 :     if (C_MEM_NUM_COL_BITS = 12)  generate --Column
                            p3_cmd_ca(11 downto 0) <= p3_cmd_byte_addr(C_MEM_NUM_COL_BITS - 1  downto  0);

                end generate;

 x8_p3_ca12_n :     if (not(C_MEM_NUM_COL_BITS = 12))  generate --Column
                            p3_cmd_ca(11 downto 0) <= (allzero(11  downto  C_MEM_NUM_COL_BITS) & p3_cmd_byte_addr(C_MEM_NUM_COL_BITS - 1  downto  0));

                end generate;

                
--   port 4 address remapping
 x8_p4_a15      : if (C_MEM_ADDR_WIDTH = 15) generate -- Row
                            p4_cmd_ra <= p4_cmd_byte_addr(C_MEM_ADDR_WIDTH + C_MEM_BANKADDR_WIDTH +  C_MEM_NUM_COL_BITS - 1   downto  C_MEM_BANKADDR_WIDTH +  C_MEM_NUM_COL_BITS );

                end generate;

 x8_p4_a15_n : if (not(C_MEM_ADDR_WIDTH = 15)) generate --Row
                            p4_cmd_ra <= (allzero(14  downto  C_MEM_ADDR_WIDTH) & p4_cmd_byte_addr(C_MEM_ADDR_WIDTH + C_MEM_BANKADDR_WIDTH +  C_MEM_NUM_COL_BITS - 1   downto  C_MEM_BANKADDR_WIDTH +  C_MEM_NUM_COL_BITS ));

                   end generate;
                      

 x8_p4_ba3 :       if (C_MEM_BANKADDR_WIDTH  = 3 ) generate --Bank
                            p4_cmd_ba <= p4_cmd_byte_addr(C_MEM_BANKADDR_WIDTH +  C_MEM_NUM_COL_BITS - 1  downto   C_MEM_NUM_COL_BITS );  --14,3,10

                end generate;

 x8_p4_ba3_n :   if (not(C_MEM_BANKADDR_WIDTH  = 3 )) generate --Bank
                            p4_cmd_ba <= (allzero(2  downto  C_MEM_BANKADDR_WIDTH)&  
                                   p4_cmd_byte_addr(C_MEM_BANKADDR_WIDTH +  C_MEM_NUM_COL_BITS - 1  downto  C_MEM_NUM_COL_BITS ));  --14,3,10

                end generate;

                
 x8_p4_ca12 :     if (C_MEM_NUM_COL_BITS = 12)  generate --Column
                            p4_cmd_ca(11 downto 0) <= p4_cmd_byte_addr(C_MEM_NUM_COL_BITS - 1  downto  0);

                end generate;

 x8_p4_ca12_n :     if (not(C_MEM_NUM_COL_BITS = 12))  generate --Column
                            p4_cmd_ca(11 downto 0) <= (allzero(11  downto  C_MEM_NUM_COL_BITS) & p4_cmd_byte_addr(C_MEM_NUM_COL_BITS - 1  downto  0));

                end generate;

                  

 --   port 5 address remapping
  x8_p5_a15     : if (C_MEM_ADDR_WIDTH = 15) generate -- Row
                           p5_cmd_ra <= p5_cmd_byte_addr(C_MEM_ADDR_WIDTH + C_MEM_BANKADDR_WIDTH +  C_MEM_NUM_COL_BITS - 1   downto  C_MEM_BANKADDR_WIDTH +  C_MEM_NUM_COL_BITS );

                end generate;

 x8_p5_a15_n : if (not(C_MEM_ADDR_WIDTH = 15)) generate --Row
                            p5_cmd_ra <= (allzero(14  downto  C_MEM_ADDR_WIDTH) & p5_cmd_byte_addr(C_MEM_ADDR_WIDTH + C_MEM_BANKADDR_WIDTH +  C_MEM_NUM_COL_BITS - 1   downto  C_MEM_BANKADDR_WIDTH +  C_MEM_NUM_COL_BITS ));

                   end generate;
                      

 x8_p5_ba3 :       if (C_MEM_BANKADDR_WIDTH  = 3 ) generate --Bank
                            p5_cmd_ba <= p5_cmd_byte_addr(C_MEM_BANKADDR_WIDTH +  C_MEM_NUM_COL_BITS - 1  downto   C_MEM_NUM_COL_BITS );  --14,3,10

                end generate;

 x8_p5_ba3_n :   if (not(C_MEM_BANKADDR_WIDTH  = 3 )) generate --Bank
                            p5_cmd_ba <= (allzero(2  downto  C_MEM_BANKADDR_WIDTH)&  
                                   p5_cmd_byte_addr(C_MEM_BANKADDR_WIDTH +  C_MEM_NUM_COL_BITS - 1  downto  C_MEM_NUM_COL_BITS ));  --14,3,10

                end generate;

                
 x8_p5_ca12 :     if (C_MEM_NUM_COL_BITS = 12)  generate --Column
                            p5_cmd_ca(11 downto 0) <= p5_cmd_byte_addr(C_MEM_NUM_COL_BITS - 1  downto  0);

                end generate;

 x8_p5_ca12_n :     if (not(C_MEM_NUM_COL_BITS = 12))  generate --Column
                            p5_cmd_ca(11 downto 0) <= (allzero(11  downto  C_MEM_NUM_COL_BITS) & p5_cmd_byte_addr(C_MEM_NUM_COL_BITS - 1  downto  0));

                end generate;
  end generate; --x8_addr_rbc


                 
x8_addr_rbc_n   : if (not(C_MEM_ADDR_ORDER = "ROW_BANK_COLUMN")) generate 
 -- port 0 address remapping
  x8_rbc_n_p0_ba3 :if (C_MEM_BANKADDR_WIDTH  = 3 ) generate --Bank
                             p0_cmd_ba <= p0_cmd_byte_addr(C_MEM_ADDR_WIDTH  +  C_MEM_BANKADDR_WIDTH +  C_MEM_NUM_COL_BITS - 1  downto  C_MEM_ADDR_WIDTH  +  C_MEM_NUM_COL_BITS );  

                end generate;

 x8_rbc_n_p0_ba3_n :if (not(C_MEM_BANKADDR_WIDTH  = 3 )) generate --Bank
                            p0_cmd_ba <= (allzero(2  downto  C_MEM_BANKADDR_WIDTH)&  
                                   p0_cmd_byte_addr(C_MEM_ADDR_WIDTH  +  C_MEM_BANKADDR_WIDTH +  C_MEM_NUM_COL_BITS - 1  downto  C_MEM_ADDR_WIDTH  +  C_MEM_NUM_COL_BITS ));  

                end generate;

 x8_rbc_n_p0_a15: if (C_MEM_ADDR_WIDTH = 15) generate -- Row
                            p0_cmd_ra <= p0_cmd_byte_addr(C_MEM_ADDR_WIDTH  + C_MEM_NUM_COL_BITS - 1   downto   C_MEM_NUM_COL_BITS );

                end generate;

 x8_rbc_n_p0_a15_n : if (not(C_MEM_ADDR_WIDTH = 15)) generate --Row
                            p0_cmd_ra <= (allzero(14  downto  C_MEM_ADDR_WIDTH) & p0_cmd_byte_addr(C_MEM_ADDR_WIDTH  +  C_MEM_NUM_COL_BITS - 1   downto  C_MEM_NUM_COL_BITS ));                

                   end generate;

                
 x8_rbc_n_p0_ca12 : if (C_MEM_NUM_COL_BITS = 12)  generate --Column
                            p0_cmd_ca(11 downto 0) <= p0_cmd_byte_addr(C_MEM_NUM_COL_BITS - 1  downto  0);

                end generate;

 x8_rbc_n_p0_ca12_n : if (not(C_MEM_NUM_COL_BITS = 12))  generate --Column
                            p0_cmd_ca(11 downto 0) <= (allzero(11  downto  C_MEM_NUM_COL_BITS) & p0_cmd_byte_addr(C_MEM_NUM_COL_BITS - 1  downto  0));

                end generate;


 -- port 1 address remapping
  x8_rbc_n_p1_ba3 :if (C_MEM_BANKADDR_WIDTH  = 3 ) generate --Bank
                             p1_cmd_ba <= p1_cmd_byte_addr(C_MEM_ADDR_WIDTH  +  C_MEM_BANKADDR_WIDTH +  C_MEM_NUM_COL_BITS - 1  downto  C_MEM_ADDR_WIDTH  +  C_MEM_NUM_COL_BITS );  

                end generate;

 x8_rbc_n_p1_ba3_n :if (not(C_MEM_BANKADDR_WIDTH  = 3 )) generate --Bank
                            p1_cmd_ba <= (allzero(2  downto  C_MEM_BANKADDR_WIDTH)&  
                                   p1_cmd_byte_addr(C_MEM_ADDR_WIDTH  +  C_MEM_BANKADDR_WIDTH +  C_MEM_NUM_COL_BITS - 1  downto  C_MEM_ADDR_WIDTH  +  C_MEM_NUM_COL_BITS ));  

                end generate;

 x8_rbc_n_p1_a15: if (C_MEM_ADDR_WIDTH = 15) generate -- Row
                            p1_cmd_ra <= p1_cmd_byte_addr(C_MEM_ADDR_WIDTH  + C_MEM_NUM_COL_BITS - 1   downto   C_MEM_NUM_COL_BITS );

                end generate;

 x8_rbc_n_p1_a15_n : if (not(C_MEM_ADDR_WIDTH = 15)) generate --Row
                            p1_cmd_ra <= (allzero(14  downto  C_MEM_ADDR_WIDTH) & p1_cmd_byte_addr(C_MEM_ADDR_WIDTH  +  C_MEM_NUM_COL_BITS - 1   downto  C_MEM_NUM_COL_BITS ));

                   end generate;

                
 x8_rbc_n_p1_ca12 : if (C_MEM_NUM_COL_BITS = 12)  generate --Column
                            p1_cmd_ca(11 downto 0) <= p1_cmd_byte_addr(C_MEM_NUM_COL_BITS - 1  downto  0);

                end generate;

 x8_rbc_n_p1_ca12_n : if (not(C_MEM_NUM_COL_BITS = 12))  generate --Column
                            p1_cmd_ca(11 downto 0) <= (allzero(11  downto  C_MEM_NUM_COL_BITS) & p1_cmd_byte_addr(C_MEM_NUM_COL_BITS - 1  downto  0));

                end generate;

                
--port 2 address remapping
 x8_rbc_n_p2_ba3 :if (C_MEM_BANKADDR_WIDTH  = 3 ) generate --Bank
                         p2_cmd_ba <= p2_cmd_byte_addr(C_MEM_ADDR_WIDTH  +  C_MEM_BANKADDR_WIDTH +  C_MEM_NUM_COL_BITS - 1  downto  C_MEM_ADDR_WIDTH  +  C_MEM_NUM_COL_BITS );  

                end generate;

 x8_rbc_n_p2_ba3_n :if (not(C_MEM_BANKADDR_WIDTH  = 3 )) generate --Bank
                         p2_cmd_ba <= (allzero(2  downto  C_MEM_BANKADDR_WIDTH)&  
                                        p2_cmd_byte_addr(C_MEM_ADDR_WIDTH  +  C_MEM_BANKADDR_WIDTH +  C_MEM_NUM_COL_BITS - 1  downto  C_MEM_ADDR_WIDTH  +  C_MEM_NUM_COL_BITS  ));  

                end generate;

 x8_rbc_n_p2_a15: if (C_MEM_ADDR_WIDTH = 15) generate -- Row
                            p2_cmd_ra <= p2_cmd_byte_addr(C_MEM_ADDR_WIDTH  + C_MEM_NUM_COL_BITS - 1   downto   C_MEM_NUM_COL_BITS );

                end generate;

 x8_rbc_n_p2_a15_n : if (not(C_MEM_ADDR_WIDTH = 15)) generate --Row
                            p2_cmd_ra <= (allzero(14  downto  C_MEM_ADDR_WIDTH) & p2_cmd_byte_addr(C_MEM_ADDR_WIDTH  +  C_MEM_NUM_COL_BITS - 1   downto  C_MEM_NUM_COL_BITS ));

                   end generate;

                
 x8_rbc_n_p2_ca12 : if (C_MEM_NUM_COL_BITS = 12)  generate --Column
                            p2_cmd_ca(11 downto 0) <= p2_cmd_byte_addr(C_MEM_NUM_COL_BITS - 1  downto  0);

                end generate;

 x8_rbc_n_p2_ca12_n : if (not(C_MEM_NUM_COL_BITS = 12))  generate --Column
                            p2_cmd_ca(11 downto 0) <= (allzero(11  downto  C_MEM_NUM_COL_BITS) & p2_cmd_byte_addr(C_MEM_NUM_COL_BITS - 1  downto  0));

                end generate;


 -- port 3 address remapping
  x8_rbc_n_p3_ba3 :if (C_MEM_BANKADDR_WIDTH  = 3 ) generate --Bank
                             p3_cmd_ba <= p3_cmd_byte_addr(C_MEM_ADDR_WIDTH  +  C_MEM_BANKADDR_WIDTH +  C_MEM_NUM_COL_BITS - 1  downto  C_MEM_ADDR_WIDTH  +  C_MEM_NUM_COL_BITS );  

                end generate;

 x8_rbc_n_p3_ba3_n :if (not(C_MEM_BANKADDR_WIDTH  = 3 )) generate --Bank
                            p3_cmd_ba <= (allzero(2  downto  C_MEM_BANKADDR_WIDTH)&  
                                   p3_cmd_byte_addr(C_MEM_ADDR_WIDTH  +  C_MEM_BANKADDR_WIDTH +  C_MEM_NUM_COL_BITS - 1  downto  C_MEM_ADDR_WIDTH  +  C_MEM_NUM_COL_BITS ));  

                end generate;

 x8_rbc_n_p3_a15: if (C_MEM_ADDR_WIDTH = 15) generate -- Row
                            p3_cmd_ra <= p3_cmd_byte_addr(C_MEM_ADDR_WIDTH  + C_MEM_NUM_COL_BITS - 1   downto   C_MEM_NUM_COL_BITS );

                end generate;

 x8_rbc_n_p3_a15_n : if (not(C_MEM_ADDR_WIDTH = 15)) generate --Row
                            p3_cmd_ra <= (allzero(14  downto  C_MEM_ADDR_WIDTH) & p3_cmd_byte_addr(C_MEM_ADDR_WIDTH  +  C_MEM_NUM_COL_BITS - 1   downto  C_MEM_NUM_COL_BITS ));

                   end generate;

                
 x8_rbc_n_p3_ca12 : if (C_MEM_NUM_COL_BITS = 12)  generate --Column
                            p3_cmd_ca(11 downto 0) <= p3_cmd_byte_addr(C_MEM_NUM_COL_BITS - 1  downto  0);

                end generate;

 x8_rbc_n_p3_ca12_n : if (not(C_MEM_NUM_COL_BITS = 12))  generate --Column
                            p3_cmd_ca(11 downto 0) <= (allzero(11  downto  C_MEM_NUM_COL_BITS) & p3_cmd_byte_addr(C_MEM_NUM_COL_BITS - 1  downto  0));

                end generate;

   
   
--   port 4 address remapping
 x8_rbc_n_p4_ba3 :if (C_MEM_BANKADDR_WIDTH  = 3 ) generate --Bank
                            p4_cmd_ba <= p4_cmd_byte_addr(C_MEM_ADDR_WIDTH  +  C_MEM_BANKADDR_WIDTH +  C_MEM_NUM_COL_BITS - 1  downto  C_MEM_ADDR_WIDTH  +  C_MEM_NUM_COL_BITS );  

                end generate;

 x8_rbc_n_p4_ba3_n :if (not(C_MEM_BANKADDR_WIDTH  = 3 )) generate --Bank
                        p4_cmd_ba <= (allzero(2 downto C_MEM_BANKADDR_WIDTH) &  
                                   p4_cmd_byte_addr(C_MEM_ADDR_WIDTH  +  C_MEM_BANKADDR_WIDTH +  C_MEM_NUM_COL_BITS - 1 downto C_MEM_ADDR_WIDTH  +  C_MEM_NUM_COL_BITS ));  
                end generate;

 x8_rbc_n_p4_a15: if (C_MEM_ADDR_WIDTH = 15) generate -- Row
                            p4_cmd_ra <= p4_cmd_byte_addr(C_MEM_ADDR_WIDTH  + C_MEM_NUM_COL_BITS - 1   downto   C_MEM_NUM_COL_BITS );

                end generate;

 x8_rbc_n_p4_a15_n : if (not(C_MEM_ADDR_WIDTH = 15)) generate --Row
                            p4_cmd_ra <= (allzero(14  downto  C_MEM_ADDR_WIDTH) & p4_cmd_byte_addr(C_MEM_ADDR_WIDTH  +  C_MEM_NUM_COL_BITS - 1   downto  C_MEM_NUM_COL_BITS ));

                   end generate;

                
 x8_rbc_n_p4_ca12 : if (C_MEM_NUM_COL_BITS = 12)  generate --Column
                            p4_cmd_ca(11 downto 0) <= p4_cmd_byte_addr(C_MEM_NUM_COL_BITS - 1  downto  0);

                end generate;

 x8_rbc_n_p4_ca12_n : if (not(C_MEM_NUM_COL_BITS = 12))  generate --Column
                            p4_cmd_ca(11 downto 0) <= (allzero(11  downto  C_MEM_NUM_COL_BITS) & p4_cmd_byte_addr(C_MEM_NUM_COL_BITS - 1  downto  0));

                end generate;


--   port 5 address remapping
 x8_rbc_n_p5_ba3 :if (C_MEM_BANKADDR_WIDTH  = 3 ) generate --Bank
                            p5_cmd_ba <= p5_cmd_byte_addr(C_MEM_ADDR_WIDTH  +  C_MEM_BANKADDR_WIDTH +  C_MEM_NUM_COL_BITS - 1  downto  C_MEM_ADDR_WIDTH  +  C_MEM_NUM_COL_BITS );  

                end generate;

 x8_rbc_n_p5_ba3_n :if (not(C_MEM_BANKADDR_WIDTH  = 3 )) generate --Bank
                            p5_cmd_ba <= (allzero(2  downto  C_MEM_BANKADDR_WIDTH)&  
                                   p5_cmd_byte_addr(C_MEM_ADDR_WIDTH  +  C_MEM_BANKADDR_WIDTH +  C_MEM_NUM_COL_BITS - 1  downto  C_MEM_ADDR_WIDTH  +  C_MEM_NUM_COL_BITS ));  

                end generate;

 x8_rbc_n_p5_a15: if (C_MEM_ADDR_WIDTH = 15) generate -- Row
                            p5_cmd_ra <= p5_cmd_byte_addr(C_MEM_ADDR_WIDTH  + C_MEM_NUM_COL_BITS - 1   downto   C_MEM_NUM_COL_BITS );

                end generate;

 x8_rbc_n_p5_a15_n : if (not(C_MEM_ADDR_WIDTH = 15)) generate --Row
                            p5_cmd_ra <= (allzero(14  downto  C_MEM_ADDR_WIDTH) & p5_cmd_byte_addr(C_MEM_ADDR_WIDTH  +  C_MEM_NUM_COL_BITS - 1   downto  C_MEM_NUM_COL_BITS ));

                   end generate;

                
 x8_rbc_n_p5_ca12 : if (C_MEM_NUM_COL_BITS = 12)  generate --Column
                            p5_cmd_ca(11 downto 0) <= p5_cmd_byte_addr(C_MEM_NUM_COL_BITS - 1  downto  0);

                end generate;

 x8_rbc_n_p5_ca12_n : if (not(C_MEM_NUM_COL_BITS = 12))  generate --Column
                            p5_cmd_ca(11 downto 0) <= (allzero(11  downto  C_MEM_NUM_COL_BITS) & p5_cmd_byte_addr(C_MEM_NUM_COL_BITS - 1  downto  0));

                end generate;
  end generate; --x8_addr_rbc_n
 end generate;  --x8_addr
             








x4_addr : if(C_NUM_DQ_PINS = 4) generate
x4_addr_rbc     : if (C_MEM_ADDR_ORDER = "ROW_BANK_COLUMN") generate 

--   port 0 address remapping
x4_p0_a15       : if (C_MEM_ADDR_WIDTH = 15) generate -- Row
                      p0_cmd_ra <= p0_cmd_byte_addr(C_MEM_ADDR_WIDTH + C_MEM_BANKADDR_WIDTH +  C_MEM_NUM_COL_BITS - 2  downto  C_MEM_BANKADDR_WIDTH + C_MEM_NUM_COL_BITS - 1);

                end generate;

 x4_p0_a15_n : if (not(C_MEM_ADDR_WIDTH = 15)) generate --Row
                       p0_cmd_ra <= (allzero(14  downto  C_MEM_ADDR_WIDTH ) & p0_cmd_byte_addr(C_MEM_ADDR_WIDTH +  C_MEM_BANKADDR_WIDTH + C_MEM_NUM_COL_BITS - 2  downto  C_MEM_BANKADDR_WIDTH + C_MEM_NUM_COL_BITS - 1));

                   end generate;
                      

 x4_p0_ba3 :       if (C_MEM_BANKADDR_WIDTH  = 3 ) generate --Bank
                        p0_cmd_ba <=  p0_cmd_byte_addr(C_MEM_BANKADDR_WIDTH + C_MEM_NUM_COL_BITS - 2  downto   C_MEM_NUM_COL_BITS - 1);

                end generate;

 x4_p0_ba3_n :   if (not(C_MEM_BANKADDR_WIDTH  = 3 )) generate --Bank
                        p0_cmd_ba <= (allzero(2  downto  C_MEM_BANKADDR_WIDTH ) & p0_cmd_byte_addr(C_MEM_BANKADDR_WIDTH + C_MEM_NUM_COL_BITS - 2  downto   C_MEM_NUM_COL_BITS - 1));

                end generate;

                
 x4_p0_ca12 :     if (C_MEM_NUM_COL_BITS = 12)  generate --Column
                       p0_cmd_ca <= (p0_cmd_byte_addr(C_MEM_NUM_COL_BITS - 2  downto  0) & '0');                                --14,3,11

                end generate;

 x4_p0_ca12_n :     if (not(C_MEM_NUM_COL_BITS = 12))  generate --Column
                       p0_cmd_ca <= (allzero(11  downto  C_MEM_NUM_COL_BITS ) &  p0_cmd_byte_addr(C_MEM_NUM_COL_BITS - 2  downto  0) & '0');

                end generate;
               
           
--   port 1 address remapping
x4_p1_a15       : if (C_MEM_ADDR_WIDTH = 15) generate -- Row
                      p1_cmd_ra <= p1_cmd_byte_addr(C_MEM_ADDR_WIDTH + C_MEM_BANKADDR_WIDTH +  C_MEM_NUM_COL_BITS - 2  downto  C_MEM_BANKADDR_WIDTH + C_MEM_NUM_COL_BITS - 1);

                end generate;

 x4_p1_a15_n : if (not(C_MEM_ADDR_WIDTH = 15)) generate --Row
                       p1_cmd_ra <= (allzero(14  downto  C_MEM_ADDR_WIDTH ) & p1_cmd_byte_addr(C_MEM_ADDR_WIDTH +  C_MEM_BANKADDR_WIDTH + C_MEM_NUM_COL_BITS - 2  downto  C_MEM_BANKADDR_WIDTH + C_MEM_NUM_COL_BITS - 1));

                   end generate;
                      

 x4_p1_ba3 :       if (C_MEM_BANKADDR_WIDTH  = 3 ) generate --Bank
                        p1_cmd_ba <=  p1_cmd_byte_addr(C_MEM_BANKADDR_WIDTH + C_MEM_NUM_COL_BITS - 2  downto   C_MEM_NUM_COL_BITS - 1);

                end generate;

 x4_p1_ba3_n :   if (not(C_MEM_BANKADDR_WIDTH  = 3 )) generate --Bank
                        p1_cmd_ba <= (allzero(2  downto  C_MEM_BANKADDR_WIDTH ) & p1_cmd_byte_addr(C_MEM_BANKADDR_WIDTH + C_MEM_NUM_COL_BITS - 2  downto   C_MEM_NUM_COL_BITS - 1));

                end generate;

                
 x4_p1_ca12 :     if (C_MEM_NUM_COL_BITS = 12)  generate --Column
                       p1_cmd_ca <= (p1_cmd_byte_addr(C_MEM_NUM_COL_BITS - 2  downto  0) & '0');                                --14,3,11

                end generate;

 x4_p1_ca12_n :     if (not(C_MEM_NUM_COL_BITS = 12))  generate --Column
                       p1_cmd_ca <= (allzero(11  downto  C_MEM_NUM_COL_BITS ) &  p1_cmd_byte_addr(C_MEM_NUM_COL_BITS - 2  downto  0) & '0');

                end generate;


--   port 2 address remapping
x4_p2_a15       : if (C_MEM_ADDR_WIDTH = 15) generate -- Row
                      p2_cmd_ra <= p2_cmd_byte_addr(C_MEM_ADDR_WIDTH + C_MEM_BANKADDR_WIDTH +  C_MEM_NUM_COL_BITS - 2  downto  C_MEM_BANKADDR_WIDTH + C_MEM_NUM_COL_BITS - 1);

                end generate;

 x4_p2_a15_n : if (not(C_MEM_ADDR_WIDTH = 15)) generate --Row
                       p2_cmd_ra <= (allzero(14  downto  C_MEM_ADDR_WIDTH ) & p2_cmd_byte_addr(C_MEM_ADDR_WIDTH +  C_MEM_BANKADDR_WIDTH + C_MEM_NUM_COL_BITS - 2  downto  C_MEM_BANKADDR_WIDTH + C_MEM_NUM_COL_BITS - 1));
                   end generate;
                      

 x4_p2_ba3 :       if (C_MEM_BANKADDR_WIDTH  = 3 ) generate --Bank
                        p2_cmd_ba <=  p2_cmd_byte_addr(C_MEM_BANKADDR_WIDTH + C_MEM_NUM_COL_BITS - 2  downto   C_MEM_NUM_COL_BITS - 1);

                end generate;

 x4_p2_ba3_n :   if (not(C_MEM_BANKADDR_WIDTH  = 3 )) generate --Bank
                        p2_cmd_ba <= (allzero(2  downto  C_MEM_BANKADDR_WIDTH ) & p2_cmd_byte_addr(C_MEM_BANKADDR_WIDTH + C_MEM_NUM_COL_BITS - 2  downto   C_MEM_NUM_COL_BITS - 1));

                end generate;

                
 x4_p2_ca12 :     if (C_MEM_NUM_COL_BITS = 12)  generate --Column
                       p2_cmd_ca <= (p2_cmd_byte_addr(C_MEM_NUM_COL_BITS - 2  downto  0) & '0');                                --14,3,11

                end generate;

 x4_p2_ca12_n :     if (not(C_MEM_NUM_COL_BITS = 12))  generate --Column
                       p2_cmd_ca <= (allzero(11  downto  C_MEM_NUM_COL_BITS ) &  p2_cmd_byte_addr(C_MEM_NUM_COL_BITS - 2  downto  0) & '0');

                end generate;


--   port 3 address remapping
x4_p3_a15       : if (C_MEM_ADDR_WIDTH = 15) generate -- Row
                      p3_cmd_ra <= p3_cmd_byte_addr(C_MEM_ADDR_WIDTH + C_MEM_BANKADDR_WIDTH +  C_MEM_NUM_COL_BITS - 2  downto  C_MEM_BANKADDR_WIDTH + C_MEM_NUM_COL_BITS - 1);

                end generate;

 x4_p3_a15_n : if (not(C_MEM_ADDR_WIDTH = 15)) generate --Row
                       p3_cmd_ra <= (allzero(14  downto  C_MEM_ADDR_WIDTH ) & p3_cmd_byte_addr(C_MEM_ADDR_WIDTH +  C_MEM_BANKADDR_WIDTH + C_MEM_NUM_COL_BITS - 2  downto  C_MEM_BANKADDR_WIDTH + C_MEM_NUM_COL_BITS - 1));

                   end generate;
                      

 x4_p3_ba3 :       if (C_MEM_BANKADDR_WIDTH  = 3 ) generate --Bank
                        p3_cmd_ba <=  p3_cmd_byte_addr(C_MEM_BANKADDR_WIDTH + C_MEM_NUM_COL_BITS - 2  downto   C_MEM_NUM_COL_BITS - 1);

                end generate;

 x4_p3_ba3_n :   if (not(C_MEM_BANKADDR_WIDTH  = 3 )) generate --Bank
                        p3_cmd_ba <= (allzero(2  downto  C_MEM_BANKADDR_WIDTH ) & p3_cmd_byte_addr(C_MEM_BANKADDR_WIDTH + C_MEM_NUM_COL_BITS - 2  downto   C_MEM_NUM_COL_BITS - 1));

                end generate;

                
 x4_p3_ca12 :     if (C_MEM_NUM_COL_BITS = 12)  generate --Column
                       p3_cmd_ca <= (p3_cmd_byte_addr(C_MEM_NUM_COL_BITS - 2  downto  0) & '0');                                --14,3,11

                end generate;

 x4_p3_ca12_n :     if (not(C_MEM_NUM_COL_BITS = 12))  generate --Column
                       p3_cmd_ca <= (allzero(11  downto  C_MEM_NUM_COL_BITS ) &  p3_cmd_byte_addr(C_MEM_NUM_COL_BITS - 2  downto  0) & '0');

                end generate;




 

 x4_p4_p5:if(C_PORT_CONFIG = "B32_B32_R32_R32_R32_R32" or
             C_PORT_CONFIG = "B32_B32_R32_R32_R32_W32" or
             C_PORT_CONFIG = "B32_B32_R32_R32_W32_R32" or
             C_PORT_CONFIG = "B32_B32_R32_R32_W32_W32" or
             C_PORT_CONFIG = "B32_B32_R32_W32_R32_R32" or
             C_PORT_CONFIG = "B32_B32_R32_W32_R32_W32" or
             C_PORT_CONFIG = "B32_B32_R32_W32_W32_R32" or
             C_PORT_CONFIG = "B32_B32_R32_W32_W32_W32" or
             C_PORT_CONFIG = "B32_B32_W32_R32_R32_R32" or
             C_PORT_CONFIG = "B32_B32_W32_R32_R32_W32" or
             C_PORT_CONFIG = "B32_B32_W32_R32_W32_R32" or
             C_PORT_CONFIG = "B32_B32_W32_R32_W32_W32" or
             C_PORT_CONFIG = "B32_B32_W32_W32_R32_R32" or
             C_PORT_CONFIG = "B32_B32_W32_W32_R32_W32" or
             C_PORT_CONFIG = "B32_B32_W32_W32_W32_R32" or
             C_PORT_CONFIG = "B32_B32_W32_W32_W32_W32"
             ) generate
--   port 4 address remapping
 
x4_p4_a15       : if (C_MEM_ADDR_WIDTH = 15) generate -- Row
                      p4_cmd_ra <= p4_cmd_byte_addr(C_MEM_ADDR_WIDTH + C_MEM_BANKADDR_WIDTH +  C_MEM_NUM_COL_BITS - 2  downto  C_MEM_BANKADDR_WIDTH + C_MEM_NUM_COL_BITS - 1);

                end generate;

x4_p4_a15_n : if (not(C_MEM_ADDR_WIDTH = 15)) generate --Row
                      p4_cmd_ra <= (allzero(14  downto  C_MEM_ADDR_WIDTH ) & p4_cmd_byte_addr(C_MEM_ADDR_WIDTH +  C_MEM_BANKADDR_WIDTH + C_MEM_NUM_COL_BITS - 2  downto  C_MEM_BANKADDR_WIDTH + C_MEM_NUM_COL_BITS - 1));

                   end generate;
                      

x4_p4_ba3 :       if (C_MEM_BANKADDR_WIDTH  = 3 ) generate --Bank
                       p4_cmd_ba <=  p4_cmd_byte_addr(C_MEM_BANKADDR_WIDTH + C_MEM_NUM_COL_BITS - 2  downto   C_MEM_NUM_COL_BITS - 1);

                end generate;

x4_p4_ba3_n :   if (not(C_MEM_BANKADDR_WIDTH  = 3 )) generate --Bank
                       p4_cmd_ba <= (allzero(2  downto  C_MEM_BANKADDR_WIDTH ) & p4_cmd_byte_addr(C_MEM_BANKADDR_WIDTH + C_MEM_NUM_COL_BITS - 2  downto   C_MEM_NUM_COL_BITS - 1));

                end generate;

                
x4_p4_ca12 :     if (C_MEM_NUM_COL_BITS = 12)  generate --Column
                      p4_cmd_ca <= (p4_cmd_byte_addr(C_MEM_NUM_COL_BITS - 2  downto  0) & '0');                                --14,3,11

                end generate;

x4_p4_ca12_n :     if (not(C_MEM_NUM_COL_BITS = 12))  generate --Column
                      p4_cmd_ca <= (allzero(11  downto  C_MEM_NUM_COL_BITS ) &  p4_cmd_byte_addr(C_MEM_NUM_COL_BITS - 2  downto  0) & '0');

                end generate;
--   port 5 address remapping
               

x4_p5_a15       : if (C_MEM_ADDR_WIDTH = 15) generate -- Row
                      p5_cmd_ra <= p5_cmd_byte_addr(C_MEM_ADDR_WIDTH + C_MEM_BANKADDR_WIDTH +  C_MEM_NUM_COL_BITS - 2  downto  C_MEM_BANKADDR_WIDTH + C_MEM_NUM_COL_BITS - 1);

                end generate;

x4_p5_a15_n : if (not(C_MEM_ADDR_WIDTH = 15)) generate --Row
                      p5_cmd_ra <= (allzero(14  downto  C_MEM_ADDR_WIDTH ) & p5_cmd_byte_addr(C_MEM_ADDR_WIDTH +  C_MEM_BANKADDR_WIDTH + C_MEM_NUM_COL_BITS - 2  downto  C_MEM_BANKADDR_WIDTH + C_MEM_NUM_COL_BITS - 1));

                   end generate;
                      

x4_p5_ba3 :       if (C_MEM_BANKADDR_WIDTH  = 3 ) generate --Bank
                       p5_cmd_ba <=  p5_cmd_byte_addr(C_MEM_BANKADDR_WIDTH + C_MEM_NUM_COL_BITS - 2  downto   C_MEM_NUM_COL_BITS - 1);

                end generate;

x4_p5_ba3_n :   if (not(C_MEM_BANKADDR_WIDTH  = 3 )) generate --Bank
                       p5_cmd_ba <= (allzero(2  downto  C_MEM_BANKADDR_WIDTH ) & p5_cmd_byte_addr(C_MEM_BANKADDR_WIDTH + C_MEM_NUM_COL_BITS - 2  downto   C_MEM_NUM_COL_BITS - 1));

                end generate;

                
x4_p5_ca12 :     if (C_MEM_NUM_COL_BITS = 12)  generate --Column
                      p5_cmd_ca <= (p5_cmd_byte_addr(C_MEM_NUM_COL_BITS - 2  downto  0) & '0');                                --14,3,11

                end generate;

x4_p5_ca12_n :     if (not(C_MEM_NUM_COL_BITS = 12))  generate --Column
                      p5_cmd_ca <= (allzero(11  downto  C_MEM_NUM_COL_BITS ) &  p5_cmd_byte_addr(C_MEM_NUM_COL_BITS - 2  downto  0) & '0');

                end generate;
     end generate; --x4_p4_p5
 end generate; --x4_addr_rbc



              
x4_addr_rbc_n   : if (not(C_MEM_ADDR_ORDER = "ROW_BANK_COLUMN")) generate 
            
--   port 0 address remapping
  x4_rbc_n_p0_ba3 :if (C_MEM_BANKADDR_WIDTH  = 3 ) generate --Bank
                         p0_cmd_ba <=  p0_cmd_byte_addr(C_MEM_BANKADDR_WIDTH + C_MEM_ADDR_WIDTH +  C_MEM_NUM_COL_BITS - 2  downto  C_MEM_ADDR_WIDTH +  C_MEM_NUM_COL_BITS - 1);
                end generate;

 x4_rbc_n_p0_ba3_n :if (not(C_MEM_BANKADDR_WIDTH  = 3 )) generate --Bank
                        p0_cmd_ba <= (allzero(2  downto  C_MEM_BANKADDR_WIDTH ) & p0_cmd_byte_addr(C_MEM_BANKADDR_WIDTH + C_MEM_ADDR_WIDTH +  C_MEM_NUM_COL_BITS - 2  downto  C_MEM_ADDR_WIDTH +  C_MEM_NUM_COL_BITS - 1));
                end generate;

 x4_rbc_n_p0_a15: if (C_MEM_ADDR_WIDTH = 15) generate -- Row
                       p0_cmd_ra <= p0_cmd_byte_addr(C_MEM_ADDR_WIDTH +  C_MEM_NUM_COL_BITS - 2  downto  C_MEM_NUM_COL_BITS - 1);
                end generate;

 x4_rbc_n_p0_a15_n : if (not(C_MEM_ADDR_WIDTH = 15)) generate --Row
                       p0_cmd_ra <= (allzero(14  downto  C_MEM_ADDR_WIDTH ) & p0_cmd_byte_addr(C_MEM_ADDR_WIDTH +  C_MEM_NUM_COL_BITS - 2  downto  C_MEM_NUM_COL_BITS - 1));
                   end generate;

                
 x4_rbc_n_p0_ca12 : if (C_MEM_NUM_COL_BITS = 12)  generate --Column
                       p0_cmd_ca <= (p0_cmd_byte_addr(C_MEM_NUM_COL_BITS - 2  downto  0) & '0');
                end generate;

 x4_rbc_n_p0_ca12_n : if (not(C_MEM_NUM_COL_BITS = 12))  generate --Column
                       p0_cmd_ca <= (allzero(11  downto  C_MEM_NUM_COL_BITS ) &  p0_cmd_byte_addr(C_MEM_NUM_COL_BITS - 2  downto  0) & '0');
                end generate;
               
           
--   port 1 address remapping
  x4_rbc_n_p1_ba3 :if (C_MEM_BANKADDR_WIDTH  = 3 ) generate --Bank
                         p1_cmd_ba <=  p1_cmd_byte_addr(C_MEM_BANKADDR_WIDTH + C_MEM_ADDR_WIDTH +  C_MEM_NUM_COL_BITS - 2  downto  C_MEM_ADDR_WIDTH +  C_MEM_NUM_COL_BITS - 1);


                end generate;

 x4_rbc_n_p1_ba3_n :if (not(C_MEM_BANKADDR_WIDTH  = 3 )) generate --Bank
                        p1_cmd_ba <= (allzero(2  downto  C_MEM_BANKADDR_WIDTH ) & p1_cmd_byte_addr(C_MEM_BANKADDR_WIDTH + C_MEM_ADDR_WIDTH +  C_MEM_NUM_COL_BITS - 2  downto  C_MEM_ADDR_WIDTH +  C_MEM_NUM_COL_BITS - 1));

                end generate;

 x4_rbc_n_p1_a15: if (C_MEM_ADDR_WIDTH = 15) generate -- Row
                       p1_cmd_ra <= p1_cmd_byte_addr(C_MEM_ADDR_WIDTH +  C_MEM_NUM_COL_BITS - 2  downto  C_MEM_NUM_COL_BITS - 1);


                end generate;

 x4_rbc_n_p1_a15_n : if (not(C_MEM_ADDR_WIDTH = 15)) generate --Row
                       p1_cmd_ra <= (allzero(14  downto  C_MEM_ADDR_WIDTH ) & p1_cmd_byte_addr(C_MEM_ADDR_WIDTH +  C_MEM_NUM_COL_BITS - 2  downto  C_MEM_NUM_COL_BITS - 1));


                   end generate;

                
 x4_rbc_n_p1_ca12 : if (C_MEM_NUM_COL_BITS = 12)  generate --Column
                       p1_cmd_ca <= (p1_cmd_byte_addr(C_MEM_NUM_COL_BITS - 2  downto  0) & '0');


                end generate;

 x4_rbc_n_p1_ca12_n : if (not(C_MEM_NUM_COL_BITS = 12))  generate --Column
                       p1_cmd_ca <= (allzero(11  downto  C_MEM_NUM_COL_BITS ) &  p1_cmd_byte_addr(C_MEM_NUM_COL_BITS - 2  downto  0) & '0');


                end generate;
            
--   port 2 address remapping
  x4_rbc_n_p2_ba3 :if (C_MEM_BANKADDR_WIDTH  = 3 ) generate --Bank
                         p2_cmd_ba <=  p2_cmd_byte_addr(C_MEM_BANKADDR_WIDTH + C_MEM_ADDR_WIDTH +  C_MEM_NUM_COL_BITS - 2  downto  C_MEM_ADDR_WIDTH +  C_MEM_NUM_COL_BITS - 1);


                end generate;

 x4_rbc_n_p2_ba3_n :if (not(C_MEM_BANKADDR_WIDTH  = 3 )) generate --Bank
                        p2_cmd_ba <= (allzero(2  downto  C_MEM_BANKADDR_WIDTH ) & p2_cmd_byte_addr(C_MEM_BANKADDR_WIDTH + C_MEM_ADDR_WIDTH +  C_MEM_NUM_COL_BITS - 2  downto  C_MEM_ADDR_WIDTH +  C_MEM_NUM_COL_BITS - 1));

                end generate;

 x4_rbc_n_p2_a15: if (C_MEM_ADDR_WIDTH = 15) generate -- Row
                       p2_cmd_ra <= p2_cmd_byte_addr(C_MEM_ADDR_WIDTH +  C_MEM_NUM_COL_BITS - 2  downto  C_MEM_NUM_COL_BITS - 1);


                end generate;

 x4_rbc_n_p2_a15_n : if (not(C_MEM_ADDR_WIDTH = 15)) generate --Row
                       p2_cmd_ra <= (allzero(14  downto  C_MEM_ADDR_WIDTH ) & p2_cmd_byte_addr(C_MEM_ADDR_WIDTH +  C_MEM_NUM_COL_BITS - 2  downto  C_MEM_NUM_COL_BITS - 1));


                   end generate;

                
 x4_rbc_n_p2_ca12 : if (C_MEM_NUM_COL_BITS = 12)  generate --Column
                       p2_cmd_ca <= (p2_cmd_byte_addr(C_MEM_NUM_COL_BITS - 2  downto  0) & '0');


                end generate;

 x4_rbc_n_p2_ca12_n : if (not(C_MEM_NUM_COL_BITS = 12))  generate --Column
                       p2_cmd_ca <= (allzero(11  downto  C_MEM_NUM_COL_BITS ) &  p2_cmd_byte_addr(C_MEM_NUM_COL_BITS - 2  downto  0) & '0');


                end generate;
            
--   port 3 address remapping
  x4_rbc_n_p3_ba3 :if (C_MEM_BANKADDR_WIDTH  = 3 ) generate --Bank
                         p3_cmd_ba <=  p3_cmd_byte_addr(C_MEM_BANKADDR_WIDTH + C_MEM_ADDR_WIDTH +  C_MEM_NUM_COL_BITS - 2  downto  C_MEM_ADDR_WIDTH +  C_MEM_NUM_COL_BITS - 1);


                end generate;

 x4_rbc_n_p3_ba3_n :if (not(C_MEM_BANKADDR_WIDTH  = 3 )) generate --Bank
                        p3_cmd_ba <= (allzero(2  downto  C_MEM_BANKADDR_WIDTH ) & p3_cmd_byte_addr(C_MEM_BANKADDR_WIDTH + C_MEM_ADDR_WIDTH +  C_MEM_NUM_COL_BITS - 2  downto  C_MEM_ADDR_WIDTH +  C_MEM_NUM_COL_BITS - 1));

                end generate;

 x4_rbc_n_p3_a15: if (C_MEM_ADDR_WIDTH = 15) generate -- Row
                       p3_cmd_ra <= p3_cmd_byte_addr(C_MEM_ADDR_WIDTH +  C_MEM_NUM_COL_BITS - 2  downto  C_MEM_NUM_COL_BITS - 1);


                end generate;

 x4_rbc_n_p3_a15_n : if (not(C_MEM_ADDR_WIDTH = 15)) generate --Row
                       p3_cmd_ra <= (allzero(14  downto  C_MEM_ADDR_WIDTH ) & p3_cmd_byte_addr(C_MEM_ADDR_WIDTH +  C_MEM_NUM_COL_BITS - 2  downto  C_MEM_NUM_COL_BITS - 1));


                   end generate;

                
 x4_rbc_n_p3_ca12 : if (C_MEM_NUM_COL_BITS = 12)  generate --Column
                       p3_cmd_ca <= (p3_cmd_byte_addr(C_MEM_NUM_COL_BITS - 2  downto  0) & '0');


                end generate;

 x4_rbc_n_p3_ca12_n : if (not(C_MEM_NUM_COL_BITS = 12))  generate --Column
                       p3_cmd_ca <= (allzero(11  downto  C_MEM_NUM_COL_BITS ) &  p3_cmd_byte_addr(C_MEM_NUM_COL_BITS - 2  downto  0) & '0');


                end generate;
            

  x4_p4_p5_n:  if(C_PORT_CONFIG = "B32_B32_R32_R32_R32_R32" or
             C_PORT_CONFIG = "B32_B32_R32_R32_R32_W32" or
             C_PORT_CONFIG = "B32_B32_R32_R32_W32_R32" or
             C_PORT_CONFIG = "B32_B32_R32_R32_W32_W32" or
             C_PORT_CONFIG = "B32_B32_R32_W32_R32_R32" or
             C_PORT_CONFIG = "B32_B32_R32_W32_R32_W32" or
             C_PORT_CONFIG = "B32_B32_R32_W32_W32_R32" or
             C_PORT_CONFIG = "B32_B32_R32_W32_W32_W32" or
             C_PORT_CONFIG = "B32_B32_W32_R32_R32_R32" or
             C_PORT_CONFIG = "B32_B32_W32_R32_R32_W32" or
             C_PORT_CONFIG = "B32_B32_W32_R32_W32_R32" or
             C_PORT_CONFIG = "B32_B32_W32_R32_W32_W32" or
             C_PORT_CONFIG = "B32_B32_W32_W32_R32_R32" or
             C_PORT_CONFIG = "B32_B32_W32_W32_R32_W32" or
             C_PORT_CONFIG = "B32_B32_W32_W32_W32_R32" or
             C_PORT_CONFIG = "B32_B32_W32_W32_W32_W32"
             ) generate
--   port 4 address remapping

  x4_rbc_n_p4_ba3 :if (C_MEM_BANKADDR_WIDTH  = 3 ) generate --Bank
                         p4_cmd_ba <=  p4_cmd_byte_addr(C_MEM_BANKADDR_WIDTH + C_MEM_ADDR_WIDTH +  C_MEM_NUM_COL_BITS - 2  downto  C_MEM_ADDR_WIDTH +  C_MEM_NUM_COL_BITS - 1);


                end generate;

 x4_rbc_n_p4_ba3_n :if (not(C_MEM_BANKADDR_WIDTH  = 3 )) generate --Bank
                        p4_cmd_ba <= (allzero(2  downto  C_MEM_BANKADDR_WIDTH ) & p4_cmd_byte_addr(C_MEM_BANKADDR_WIDTH + C_MEM_ADDR_WIDTH +  C_MEM_NUM_COL_BITS - 2  downto  C_MEM_ADDR_WIDTH +  C_MEM_NUM_COL_BITS - 1));

                end generate;

 x4_rbc_n_p4_a15: if (C_MEM_ADDR_WIDTH = 15) generate -- Row
                       p4_cmd_ra <= p4_cmd_byte_addr(C_MEM_ADDR_WIDTH +  C_MEM_NUM_COL_BITS - 2  downto  C_MEM_NUM_COL_BITS - 1);


                end generate;

 x4_rbc_n_p4_a15_n : if (not(C_MEM_ADDR_WIDTH = 15)) generate --Row
                       p4_cmd_ra <= (allzero(14  downto  C_MEM_ADDR_WIDTH ) & p4_cmd_byte_addr(C_MEM_ADDR_WIDTH +  C_MEM_NUM_COL_BITS - 2  downto  C_MEM_NUM_COL_BITS - 1));


                   end generate;

                
 x4_rbc_n_p4_ca12 : if (C_MEM_NUM_COL_BITS = 12)  generate --Column
                       p4_cmd_ca <= (p4_cmd_byte_addr(C_MEM_NUM_COL_BITS - 2  downto  0) & '0');


                end generate;

 x4_rbc_n_p4_ca12_n : if (not(C_MEM_NUM_COL_BITS = 12))  generate --Column
                       p4_cmd_ca <= (allzero(11  downto  C_MEM_NUM_COL_BITS ) &  p4_cmd_byte_addr(C_MEM_NUM_COL_BITS - 2  downto  0) & '0');
               end generate;
            
 
--   port 5 address remapping

  x4_rbc_n_p5_ba3 :if (C_MEM_BANKADDR_WIDTH  = 3 ) generate --Bank
                         p5_cmd_ba <=  p5_cmd_byte_addr(C_MEM_BANKADDR_WIDTH + C_MEM_ADDR_WIDTH +  C_MEM_NUM_COL_BITS - 2  downto  C_MEM_ADDR_WIDTH +  C_MEM_NUM_COL_BITS - 1);


                end generate;

 x4_rbc_n_p5_ba3_n :if (not(C_MEM_BANKADDR_WIDTH  = 3 )) generate --Bank
                        p5_cmd_ba <= (allzero(2  downto  C_MEM_BANKADDR_WIDTH ) & p5_cmd_byte_addr(C_MEM_BANKADDR_WIDTH + C_MEM_ADDR_WIDTH +  C_MEM_NUM_COL_BITS - 2  downto  C_MEM_ADDR_WIDTH +  C_MEM_NUM_COL_BITS - 1));

                end generate;

 x4_rbc_n_p5_a15: if (C_MEM_ADDR_WIDTH = 15) generate -- Row
                       p5_cmd_ra <= p5_cmd_byte_addr(C_MEM_ADDR_WIDTH +  C_MEM_NUM_COL_BITS - 2  downto  C_MEM_NUM_COL_BITS - 1);


                end generate;

 x4_rbc_n_p5_a15_n : if (not(C_MEM_ADDR_WIDTH = 15)) generate --Row
                       p5_cmd_ra <= (allzero(14  downto  C_MEM_ADDR_WIDTH ) & p5_cmd_byte_addr(C_MEM_ADDR_WIDTH +  C_MEM_NUM_COL_BITS - 2  downto  C_MEM_NUM_COL_BITS - 1));


                   end generate;

                
 x4_rbc_n_p5_ca12 : if (C_MEM_NUM_COL_BITS = 12)  generate --Column
                       p5_cmd_ca <= (p5_cmd_byte_addr(C_MEM_NUM_COL_BITS - 2  downto  0) & '0');


                end generate;

 x4_rbc_n_p5_ca12_n : if (not(C_MEM_NUM_COL_BITS = 12))  generate --Column
                       p5_cmd_ca <= (allzero(11  downto  C_MEM_NUM_COL_BITS ) &  p5_cmd_byte_addr(C_MEM_NUM_COL_BITS - 2  downto  0) & '0');


                end generate;
            
end generate;  --x4_p4_p5_n
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
