kjaergaard-lab/fpga-servo/(commit log)

2020-06-05 Fixed memory range in dual-servo
    [Constants.vhd]
2020-06-08 Added ip-trap-servo
    Fixed a couple of small constant issues in other servos.
    [Analog_Digital_Control.vhd, Constants.vhd, iodrp_controller.vhd, iodrp_mcb_controller.vhd, mcb_raw_wrapper.vhd, mcb_soft_calibration.vhd]
2020-06-08 Built ip-trap, fixed syntax errors
    [Analog_Digital_Control.vhd, topmod.vhd]
2020-06-08 Updated servo class to handle MAX5719 DACs
    This update should remove the need for two different classes for the
    evaluation board servos and the home-built board servos. The difference
    between the two boards is encapsulated by the property dacType, and this
    controls the necessary changes inside of relevant functions.
